Avery-Digital/Assem-Stn-2-Rev1/BOM/ASSEM_STN_Rev1_BOM_Populated.xlsx

DMF Assembly Station #2 PCB March 6th, 2026
Item | Designator | Description | Type | Temperature | Value | Mfr. | Mfr. P/N | Number Per Board | Number of Boards | Quantity Total | Distributor | Dist. P/N | Price Ea | Price Total Per Board | Available | QTY TO BUY | Total Buy | Date Updated | Foot Print | Notes
1 | U44 | IC DAC 16BIT V-OUT 16WQFN |  | -40°C ~ 125°C |  | Texas Instruments | DAC80508ZRTER | 1 | 4 | 4 | DigiKey | 296-51047-2-ND (https://www.digikey.com/en/products/detail/texas-instruments/DAC80508ZRTER/9659605) | $19.82 | $79.28 | 4837 | 6 | $118.92 | 03/06/2026
2 | U23 | IC EEPROM 2MBIT I2C 8SO |  | -40°C ~ 85°C (TA) |  | STMicroelectronics | M24M02E-FMN6TP | 1 | 4 | 4 | DigiKey | 497-M24M02E-FMN6TPTR-ND (https://www.digikey.com/en/products/detail/stmicroelectronics/M24M02E-FMN6TP/21700599) | $1.53 | $6.12 | 3684 | 10 | $15.30 | 03/06/2026
3 | U22 | IC OSC SILICON 33MHZ SOT-23-5 |  | -40°C ~ 125°C |  | Analog Devices Inc. | LTC1799HS5#TRPBF | 1 | 4 | 4 | DigiKey | 505-LTC1799HS5#TRPBFTR-ND (https://www.digikey.com/en/products/detail/analog-devices-inc/LTC1799HS5-TRPBF/961179) | $6.71 | $26.84 | 2060 | 6 | $40.26 | 03/06/2026
4 | U21 | IC MCU 32BIT 1MB FLASH 176LQFP |  | -40°C ~ 85°C (TA) |  | STMicroelectronics | STM32H735IGT6 | 1 | 4 | 4 | DigiKey | 497-STM32H735IGT6-ND (https://www.digikey.com/en/products/detail/stmicroelectronics/STM32H735IGT6/18086047) | $13.27 | $53.08 | 32 | 6 | $79.62 | 03/06/2026
5 | U20 | SENSOR OPT SLOT PHOTOTRANS MODUL |  | -30°C ~ 85°C |  | Omron Electronics Inc-EMC Div | EE-SX1320 | 1 | 4 | 4 | DigiKey | 39-EE-SX1320TR-ND (https://www.digikey.com/en/products/detail/omron-electronics-inc-emc-div/EE-SX1320/6600982) | $0.74 | $2.96 | 59692 | 10 | $7.40 | 03/06/2026
6 | U19 | IC USB SERIAL FULL UART 20QFN |  | -40°C ~ 85°C |  | FTDI, Future Technology Devices International Ltd | FT231XQ-T | 1 | 4 | 4 | DigiKey | 768-1155-ND (https://www.digikey.com/en/products/detail/ftdi-future-technology-devices-international-ltd/FT231XQ-T/3749470) | $2.34 | $9.36 | 0 | 10 | $23.40 | 03/06/2026 | Backordered, but shipdate is 3/9/2026
7 | U16 | IC REG BUCK ADJ 3A 8SOPWR |  | -40°C ~ 125°C (TJ) |  | Texas Instruments | LMR33630ADDAR | 1 | 4 | 4 | DigiKey | 296-49763-2-ND (https://www.digikey.com/en/products/detail/texas-instruments/LMR33630ADDAR/8554847) | $2.55 | $10.20 | 4851 | 10 | $25.50 | 03/06/2026
8 | U13, U15, U17, U18 | IC CURR SENSE 1 CIRCUIT SOT23-6 |  | -40°C ~ 125°C |  | Texas Instruments | INA181A3IDBVT | 4 | 4 | 16 | DigiKey | 296-46636-2-ND (https://www.digikey.com/en/products/detail/texas-instruments/INA181A3IDBVT/7219036) | $0.99 | $15.84 | 5188 | 25 | $24.75 | 03/06/2026
9 | U12, U14 | IC CURR SENSE 1 CIRCUIT SOT23-6 |  | -40°C ~ 125°C |  | Texas Instruments | INA181A1IDBVR | 2 | 4 | 8 | DigiKey | 296-47656-2-ND (https://www.digikey.com/en/products/detail/texas-instruments/INA181A1IDBVR/8132990) | $0.43 | $3.44 | 20081 | 25 | $10.75 | 03/06/2026
10 | U11, U45 | EIGHT-CHANNEL, 250-KSPS, 16-BIT |  | -40°C ~ 125°C |  | Texas Instruments | ADS7066IRTER | 2 | 4 | 8 | Mouser | 595-ADS7066IRTER (https://www.mouser.com/ProductDetail/Texas-Instruments/ADS7066IRTER?qs=ST9lo4GX8V1NXvZuWWBhPA%3D%3D) | $13.23 | $105.84 | 0 | 12 | $158.76 | 03/06/2026
11 | U10, U46 | 0.2% ACCURACY 15PPM 4V REF |  | -40°C ~ 145°C (TA) |  | NOVOSENSE | NSREF3140-DSTR | 2 | 4 | 8 | DigiKey | 5380-NSREF3140-DSTR-ND (https://www.digikey.com/en/products/detail/novosense/NSREF3140-DSTR/22188769) | $2.02 | $16.16 | 2667 | 12 | $24.24 | 03/06/2026
12 | U8, U9 | IC HALF BRIDG DRV 600MA 32VFQFPN |  | -20°C ~ 125°C (TJ) |  | STMicroelectronics | L2293Q | 2 | 4 | 8 | DigiKey | 497-L2293Q-ND (https://www.digikey.com/en/products/detail/stmicroelectronics/L2293Q/5051121) | $7.49 | $59.92 | 2991 | 12 | $89.88 | 03/06/2026
13 | U7 | IC MOTOR DRIVER 5.5V-45V 32VQFN |  | -40°C ~ 150°C (TJ) |  | Texas Instruments | DRV8702DQRHBRQ1 | 1 | 4 | 4 | DigiKey | 296-DRV8702DQRHBRQ1TR-ND (https://www.digikey.com/en/products/detail/texas-instruments/DRV8702DQRHBRQ1/7056223) | $2.75 | $11.00 | 3848 | 10 | $27.50 | 03/06/2026
14 | U5, U6, U33 | IC PWR DRIVER N-CHANNEL 1:1 HPAK |  | -40°C ~ 150°C (TJ) |  | STMicroelectronics | VN5T016AHTR-E | 3 | 4 | 12 | DigiKey | 497-14315-2-ND (https://www.digikey.com/en/products/detail/stmicroelectronics/VN5T016AHTR-E/4357474) | $3.84 | $46.08 | 260 | 25 | $96.00 | 03/06/2026
15 | U4 | IC REG LINEAR 3.3V 1A SOT-223-3 |  | -40°C ~ 125°C |  | Microchip Technology | MCP1826S-3302E/DB | 1 | 4 | 4 | DigiKey | MCP1826S-3302E/DB-ND (https://www.digikey.com/en/products/detail/microchip-technology/MCP1826S-3302E-DB/1635997) | $0.91 | $3.64 | 6517 | 12 | $10.92 | 03/06/2026
16 | U3 | IC XLTR VL BIDIR 14-TSSOP |  | -40°C ~ 125°C (TA) |  | Texas Instruments | TXB0104QPWRQ1 | 1 | 4 | 4 | DigiKey | 296-27760-2-ND (https://www.digikey.com/en/products/detail/texas-instruments/TXB0104QPWRQ1/2232941) | $1.42 | $5.68 | 10963 | 10 | $14.20 | 03/06/2026
17 | U2 | IC TRANSCEIVER 0/4 16TSSOP |  | -40°C ~ 85°C |  | Texas Instruments | AM26C32IPWR | 1 | 4 | 4 | DigiKey | 296-30088-2-ND (https://www.digikey.com/en/products/detail/texas-instruments/AM26C32IPWR/1689930) | $1.06 | $4.24 | 3091 | 25 | $26.50 | 03/06/2026
18 | U1 | IC MTR DRVR BIPLR 8.2-45V 28SSOP |  | -40°C ~ 150°C (TJ) |  | Texas Instruments | DRV8825PWP | 1 | 4 | 4 | DigiKey | 296-28915-5-ND (https://www.digikey.com/en/products/detail/texas-instruments/DRV8825PWP/2676775) | $5.95 | $23.80 | 10534 | 10 | $59.50 | 03/06/2026
19 | TP10, TP11 | PC TEST POINT MULTIPURPOSE BLACK |  |  |  | Keystone Electronics | 5011 | 2 | 4 | 8 | DigiKey | 36-5011-ND (https://www.digikey.com/en/products/detail/keystone-electronics/5011/255333) | $0.32 | $2.56 | 146584 | 100 | $32.00 | 03/06/2026 | DNI
20 | TP8, TP9, TP12 | PC TEST POINT MULTIPURPOSE WHITE |  |  |  | Keystone Electronics | 5012 | 3 | 4 | 12 | DigiKey | 36-5012-ND (https://www.digikey.com/en/products/detail/keystone-electronics/5012/255334) | $0.32 | $3.84 | 152177 | 100 | $32.00 | 03/06/2026 | DNI
21 | TP1, TP2, TP3, TP4, TP5, TP6, TP7 | PC TEST POINT MULTIPURPOSE RED |  |  |  | Keystone Electronics | 5010 | 7 | 4 | 28 | DigiKey | 36-5010-ND (https://www.digikey.com/en/products/detail/keystone-electronics/5010/255332) | $0.34 | $9.52 | 169024 | 100 | $34.00 | 03/06/2026 | DNI
22 | R196 | RES SMD 8.25K OHM 0.1% 1/8W 0805 |  | -55°C ~ 155°C |  | Panasonic Electronic Components | ERA-6AEB8251V | 1 | 4 | 4 | DigiKey | 10-ERA-6AEB8251VTR-ND (https://www.digikey.com/en/products/detail/panasonic-electronic-components/ERA-6AEB8251V/2025746) | $0.10 | $0.40 | 16222 | 50 | $5.00 | 03/06/2026
23 | R171 | RES 470 OHM 1% 1/8W 0805 |  | -55°C ~ 155°C |  | YAGEO | RC0805FR-07470RL | 1 | 4 | 4 | DigiKey | 311-470CRTR-ND (https://www.digikey.com/en/products/detail/yageo/RC0805FR-07470RL/727976) | $0.10 | $0.40 | 179968 | 250 | $25.00 | 03/06/2026
24 | R154, R156 | RES 27 OHM 1% 1/8W 0805 |  | -55°C ~ 155°C |  | Stackpole Electronics Inc | RMCF0805FT27R0 | 2 | 4 | 8 | DigiKey | 738-RMCF0805FT27R0TR-ND (https://www.digikey.com/en/products/detail/stackpole-electronics-inc/RMCF0805FT27R0/1712920) | $0.10 | $0.80 | 96405 | 250 | $25.00 | 03/06/2026
25 | R112, R118 | RES SMD 100K OHM 0.1% 1/8W 0805 |  | -55°C ~ 155°C |  | Susumu | RG2012P-104-B-T5 | 2 | 4 | 8 | DigiKey | RG20P100KBTR-ND (https://www.digikey.com/en/products/detail/susumu/RG2012P-104-B-T5/1240656) | $0.10 | $0.80 | 312029 | 250 | $25.00 | 03/06/2026
26 | R84 | RES 0.015 OHM 1% 3W 2512 |  | -55°C ~ 170°C |  | Bourns Inc. | CRA2512-FZ-R015ELF | 1 | 4 | 4 | DigiKey | CRA2512-FZ-R015ELFTR-ND (https://www.digikey.com/en/products/detail/bourns-inc/CRA2512-FZ-R015ELF/2563864) | $0.55 | $2.20 | 95500 | 100 | $55.00 | 03/06/2026
27 | R55, R63, R67, R169 | RES 22K OHM 1% 1/8W 0805 |  | -55°C ~ 155°C |  | YAGEO | RC0805FR-1322KL | 4 | 4 | 16 | DigiKey | 13-RC0805FR-1322KLTR-ND (https://www.digikey.com/en/products/detail/yageo/RC0805FR-1322KL/14008208) | $0.10 | $1.60 | 278907 | 250 | $25.00 | 03/06/2026
28 | R54, R62, R66 | RES SMD 1K OHM 1% 1/4W 0805 |  | -55°C ~ 155°C |  | Vishay Dale | CRCW08051K00FKEA | 3 | 4 | 12 | DigiKey | 541-1.00KCTR-ND (https://www.digikey.com/en/products/detail/vishay-dale/CRCW08051K00FKEA/1175637) | $0.10 | $1.20 | 651385 | 250 | $25.00 | 03/06/2026
29 | R47 | RES 24.9K OHM 1% 1/8W 0805 |  | -55°C ~ 155°C |  | Stackpole Electronics Inc | RMCF0805FT24K9 | 1 | 4 | 4 | DigiKey | RMCF0805FT24K9TR-ND (https://www.digikey.com/en/products/detail/stackpole-electronics-inc/RMCF0805FT24K9/1760179) | $0.10 | $0.40 | 57139 | 250 | $25.00 | 03/06/2026
30 | R46 | RES 330 OHM 1% 1/8W 0805 |  | -55°C ~ 155°C |  | Stackpole Electronics Inc | RMCF0805FT330R | 1 | 4 | 4 | DigiKey | RMCF0805FT330RTR-ND (https://www.digikey.com/en/products/detail/stackpole-electronics-inc/RMCF0805FT330R/1760484) | $0.10 | $0.40 | 131778 | 250 | $25.00 | 03/06/2026
31 | R44, R48, R56, R58 | RES 0.04 OHM 0.5% 1/2W 0805 |  | -65°C ~ 170°C |  | Vishay Dale | WSLP0805R0400DEA | 4 | 4 | 16 | DigiKey | 541-WSLP0805R0400DEATR-ND (https://www.digikey.com/en/products/detail/vishay-dale/WSLP0805R0400DEA/9755281) | $2.50 | $40.00 | 3056 | 25 | $62.50 | 03/06/2026
32 | R43, R45 | RES 100K OHM 1% 1/8W 0805 |  | -55°C ~ 155°C |  | YAGEO | RC0805FR-07100KL | 2 | 4 | 8 | DigiKey | 311-100KCRTR-ND (https://www.digikey.com/en/products/detail/yageo/RC0805FR-07100KL/727544) | $0.10 | $0.80 | 1049600 | 1000 | $100.00 | 03/06/2026
33 | R23, R35, R49, R151, R152 | RES SMD 100 OHM 1% 1/4W 0805 |  | -55°C ~ 155°C |  | Vishay Dale | CRCW0805100RFKEA | 5 | 4 | 20 | DigiKey | 541-100CTR-ND (https://www.digikey.com/en/products/detail/vishay-dale/CRCW0805100RFKEA/1175523) | $0.10 | $2.00 | 148684 | 250 | $25.00 | 03/06/2026
34 | R19, R193, R194 | RES 4.99K OHM 1% 1/8W 0805 |  | -55°C ~ 155°C |  | Stackpole Electronics Inc | RMCF0805FT4K99 | 3 | 4 | 12 | DigiKey | RMCF0805FT4K99TR-ND (https://www.digikey.com/en/products/detail/stackpole-electronics-inc/RMCF0805FT4K99/1760698) | $0.10 | $1.20 | 174416 | 250 | $25.00 | 03/06/2026
35 | R15 | RES 49.9K OHM 1% 1/8W 0805 |  | -55°C ~ 155°C |  | Stackpole Electronics Inc | RMCF0805FT49K9 | 1 | 4 | 4 | DigiKey | RMCF0805FT49K9TR-ND (https://www.digikey.com/en/products/detail/stackpole-electronics-inc/RMCF0805FT49K9/1760272) | $0.10 | $0.40 | 175340 | 250 | $25.00 | 03/06/2026
36 | R13, R14 | RES 0.2 OHM 1% 1/2W 0805 |  | -55°C ~ 155°C |  | Panasonic Electronic Components | ERJ-6DSFR20V | 2 | 4 | 8 | DigiKey | P19315TR-ND (https://www.digikey.com/en/products/detail/panasonic-electronic-components/ERJ-6DSFR20V/6004398) | $0.27 | $2.16 | 67367 | 250 | $67.50 | 03/06/2026
37 | R12 | RES SMD 1M OHM 1% 1/4W 0805 |  | -55°C ~ 155°C |  | Vishay Dale | CRCW08051M00FKEA | 1 | 4 | 4 | DigiKey | 541-1.00MCTR-ND (https://www.digikey.com/en/products/detail/vishay-dale/CRCW08051M00FKEA/1176016) | $0.10 | $0.40 | 136752 | 250 | $25.00 | 03/06/2026
38 | R8, R9, R10, R16, R177 | RES 0 OHM JUMPER 1/8W 0805 |  | -55°C ~ 155°C |  | YAGEO | RC0805JR-070RL | 5 | 4 | 20 | DigiKey | 311-0.0ARTR-ND (https://www.digikey.com/en/products/detail/yageo/RC0805JR-070RL/728216) | $0.10 | $2.00 | 1087280 | 0 | $0.00 | 03/06/2026 | DNI
39 | R7, R11, R52, R53, R60, R61, R64, R65, R75, R83, R88, R89, R90, R91, R92, R93, R94, R95, R96, R97, R168, R178, R184, R205 | RES SMD 10K OHM 1% 1/4W 0805 |  | -55°C ~ 155°C |  | Vishay Dale | CRCW080510K0FKEA | 24 | 4 | 96 | DigiKey | 541-10.0KCTR-ND (https://www.digikey.com/en/products/detail/vishay-dale/CRCW080510K0FKEA/1175751) | $0.10 | $9.60 | 1218191 | 500 | $50.00 | 03/06/2026
40 | R6, R50 | RES 0.02 OHM 0.5% 1/2W 0805 |  | -55°C ~ 125°C |  | Panasonic Electronic Components | ERJ-6CWDR020V | 2 | 4 | 8 | DigiKey | P124408TR-ND (https://www.digikey.com/en/products/detail/panasonic-electronic-components/ERJ-6CWDR020V/10261701) | $0.61 | $4.88 | 4174 | 25 | $15.25 | 03/06/2026
41 | R1, R2, R3, R4, R5, R17, R18, R20, R21, R22, R24, R25, R26, R27, R28, R29, R30, R31, R32, R33, R34, R36, R37, R38, R39, R40, R41, R42, R51, R57, R59, R68, R69, R70, R71, R72, R73, R74, R76, R77, R78, R79, R80, R81, R82, R85, R86, R87, R98, R99, R100, R101, R102, R103, R104, R105, R106, R107, R108, R109, R110, R111, R113, R114, R115, R116, R117, R119, R120, R121, R122, R123, R124, R125, R126, R127, R128, R129, R130, R131, R132, R133, R134, R135, R136, R137, R138, R139, R140, R141, R142, R143, R144, R145, R146, R147, R148, R149, R150, R153, R155, R157, R158, R159, R160, R161, R162, R163, R164, R165, R166, R167, R170, R172, R173, R174, R175, R176, R179, R180, R181, R182, R183, R185, R186, R187, R188, R189, R190, R191, R192, R195, R197, R198, R199, R200, R201, R202, R203, R204, R206, R207, R208, R209, R210, R211, R212, R213, R214, R215, R216, R217, R218, R219, R220, R221, R222, R223, R224, R225, R226 | RES 0 OHM JUMPER 1/8W 0805 |  | -55°C ~ 155°C |  | YAGEO | RC0805JR-070RL | 161 | 4 | 644 | DigiKey | 311-0.0ARTR-ND (https://www.digikey.com/en/products/detail/yageo/RC0805JR-070RL/728216) | $0.10 | $64.40 | 1087280 | 1000 | $100.00 | 03/06/2026
42 | Q1, Q2, Q3, Q4 | BUK7S2R0-40H/SOT1235/LFPAK88 |  | -55°C ~ 175°C (TJ) |  | Nexperia USA Inc. | BUK7S2R0-40HJ | 4 | 4 | 16 | DigiKey | 1727-BUK7S2R0-40HJTR-ND (https://www.digikey.com/en/products/detail/nexperia-usa-inc/BUK7S2R0-40HJ/15777942) | $3.14 | $50.24 | 1411 | 25 | $78.50 | 03/06/2026
43 | L4 | FIXED IND 2.2UH 1.2A 138 MOHM |  | -55°C ~ 125°C |  | Murata Electronics | LQM2MPN2R2MG0L | 1 | 4 | 4 | DigiKey | 490-12072-2-ND (https://www.digikey.com/en/products/detail/murata-electronics/LQM2MPN2R2MG0L/4359179) | $0.18 | $0.72 | 41770 | 50 | $9.00 | 03/06/2026
44 | L2, L3 | FIXED IND 15UH 12.5A 20.5 MOHM |  | -40°C ~ 150°C |  | Bourns Inc. | SRP1770TA-150M | 2 | 4 | 8 | DigiKey | SRP1770TA-150MTR-ND (https://www.digikey.com/en/products/detail/bourns-inc/SRP1770TA-150M/5429636) | $3.52 | $28.16 | 1663 | 15 | $52.80 | 03/06/2026
45 | L1 | FIXED IND 8.2UH 6.25A 20 MOHM |  | -40°C ~ 125°C |  | Würth Elektronik | 744771008 | 1 | 4 | 4 | DigiKey | 732-1207-2-ND (https://www.digikey.com/en/products/detail/würth-elektronik/744771008/1638612) | $2.26 | $9.04 | 85 | 10 | $22.60 | 03/06/2026
46 | J16 | CONN HEADER VERT 10POS 1.27MM |  | -55°C ~ 125°C |  | Samtec Inc. | SHF-105-01-L-D-TH | 1 | 4 | 4 | DigiKey | SAM10711-ND (https://www.digikey.com/en/products/detail/samtec-inc/SHF-105-01-L-D-TH/6561671) | $2.32 | $9.28 | 10547 | 6 | $13.92 | 03/06/2026
47 | J15, J17 | CONN HEADER VERT 2POS 2.54MM |  | -40°C ~ 105°C |  | Harwin Inc. | M20-9730245 | 2 | 4 | 8 | DigiKey | 952-1912-ND (https://www.digikey.com/en/products/detail/harwin-inc/M20-9730245/3727879) | $0.14 | $1.12 | 5170 | 500 | $70.00 | 03/06/2026 | DNI
48 | J14 | CONN HEADER VERT 6POS 2.5MM |  | -40°C ~ 105°C |  | Molex | 1053091306 | 1 | 4 | 4 | DigiKey | WM15040-ND (https://www.digikey.com/en/products/detail/molex/1053091306/6164129) | $2.68 | $10.72 | 2329 | 6 | $16.08 | 03/06/2026
49 | J13 | CONN HEADER SMD 2POS 1.25MM |  | -35°C ~ 85°C |  | Hirose Electric Co Ltd | DF13-2P-1.25V(75) | 1 | 4 | 4 | DigiKey | H126391-ND (https://www.digikey.com/en/products/detail/hirose-electric-co-ltd/DF13-2P-1-25V-75/9170623) | $0.35 | $1.40 | 101 | 6 | $2.10 | 03/06/2026
50 | J6 | CONN HEADER VERT 3POS 3.5MM |  | -40°C ~ 105°C |  | Molex | 1722861103 | 1 | 4 | 4 | Mouser | 538-172286-1103 (https://www.mouser.com/ProductDetail/Molex/172286-1103?qs=M4iqfhoVaNopV1IS%252Blu7xQ%3D%3D) | $0.78 | $3.12 | 741 | 6 | $4.68 | 03/06/2026
51 | J5 | CONN HEADER VERT 3POS 2.5MM |  | -40°C ~ 105°C |  | Molex | 1053091103 | 1 | 4 | 4 | DigiKey | WM16866-ND (https://www.digikey.com/en/products/detail/molex/1053091103/7693147) | $1.01 | $4.04 | 20913 | 6 | $6.06 | 03/06/2026
52 | J4 | CONN HEADER VERT 2POS 2.5MM |  | -40°C ~ 105°C |  | Molex | 1053091102 | 1 | 4 | 4 | DigiKey | WM16865-ND (https://www.digikey.com/en/products/detail/molex/1053091102/7693146) | $0.71 | $2.84 | 10314 | 6 | $4.26 | 03/06/2026
53 | J3 | CONN HEADER VERT 4POS 2.5MM |  | -40°C ~ 105°C |  | Molex | 1053091104 | 1 | 4 | 4 | DigiKey | WM16867-ND (https://www.digikey.com/en/products/detail/molex/1053091104/7693148) | $1.15 | $4.60 | 12586 | 6 | $6.90 | 03/06/2026
54 | J2, J7, J8, J9, J10, J11, J12 | CONN HEADER VERT 2POS 3.5MM |  | -40°C ~ 105°C |  | Molex | 1722861102 | 7 | 4 | 28 | DigiKey | WM11570-ND (https://www.digikey.com/en/products/detail/molex/1722861102/5344267) | $0.77 | $21.56 | 8471 | 50 | $38.50 | 03/06/2026
55 | J1 | CONN HEADER VERT 5POS 2.5MM |  | -40°C ~ 105°C |  | Molex | 1053091105 | 1 | 4 | 4 | DigiKey | WM16868-ND (https://www.digikey.com/en/products/detail/molex/1053091105/7693149) | $1.40 | $5.60 | 778 | 6 | $8.40 | 03/06/2026
56 | FID1, FID2, FID3, FID4, FID5, FID6 |  |  |  |  |  |  | 6 | 4 | 24 |  |  |  | $0.00 |  |  | $0.00 |  | DNI
57 | D10, D11 | LED GREEN CLEAR 0805 SMD |  |  |  | Visual Communications Company - VCC | LSM0805452V | 2 | 4 | 8 | DigiKey | 28-LSM0805463VTR-ND (https://www.digikey.com/en/products/detail/visual-communications-company-vcc/LSM0805463V/10229614) | $0.43 | $3.44 | 3639 | 25 | $10.75 | 03/06/2026
58 | D6, D7, D8, D9 | DIODE SCHOTTKY 100V 2A SMB |  | -65°C ~ 150°C |  | Diodes Incorporated | B2100Q-13-F | 4 | 4 | 16 | DigiKey | 31-B2100Q-13-FTR-ND (https://www.digikey.com/en/products/detail/diodes-incorporated/B2100Q-13-F/6187178) | $0.57 | $9.12 | 66 | 25 | $14.25 | 03/06/2026
59 | D1, D2, D3, D4, D5 | LED BLUE CLEAR 0805 SMD |  |  |  | Visual Communications Company - VCC | LSM0805463V | 5 | 4 | 20 | DigiKey | 28-LSM0805463VTR-ND (https://www.digikey.com/en/products/detail/visual-communications-company-vcc/LSM0805463V/10229614) | $0.43 | $8.60 | 3639 | 50 | $21.50 | 03/06/2026
60 | C98, C99 | CAP CER 47PF 50V C0G/NP0 0805 |  | -55°C ~ 125°C |  | KEMET | C0805X470J5GACTU | 2 | 4 | 8 | DigiKey | 399-C0805X470J5GACTUTR-ND (https://www.digikey.com/en/products/detail/kemet/C0805X470J5GACTU/3317646) | $0.32 | $2.56 | 52749 | 250 | $80.00 | 03/06/2026
61 | C68, C69, C70, C71, C72, C73, C74, C75, C78, C79, C80, C81, C82, C83, C84, C85 | CAP CER 0.1UF 50V X7R 0805 |  | -55°C ~ 125°C |  | KYOCERA AVX | KGM21NR71H104KT | 16 | 4 | 64 | DigiKey | 478-KGM21NR71H104KTTR-ND (https://www.digikey.com/en/products/detail/kyocera-avx/KGM21NR71H104KT/563505) | $0.08 | $5.12 | 1967436 |  | $0.00 | 03/06/2026 | DNI
62 | C44, C45, C46, C47, C48, C49, C50, C51 | CAP CER 22UF 50V X7R 2220 |  | -55°C ~ 125°C |  | TDK Corporation | C5750X7R1H226M250KB | 8 | 4 | 32 | DigiKey | 445-C5750X7R1H226M250KBTR-ND (https://www.digikey.com/en/products/detail/tdk-corporation/C5750X7R1H226M250KB/13672015) | $4.39 | $140.48 | 8211 | 50 | $219.50 | 03/06/2026
63 | C17, C21, C24, C36 | CAP CER 1UF 50V X7R 0805 |  | -55°C ~ 125°C |  | Samsung Electro-Mechanics | CL21B105KBFNNNE | 4 | 4 | 16 | DigiKey | 1276-1029-2-ND (https://www.digikey.com/en/products/detail/samsung-electro-mechanics/CL21B105KBFNNNE/3886687) | $0.12 | $1.92 | 1573586 | 250 | $30.00 | 03/06/2026
64 | C14, C15, C16 | CAP CER 47UF 10V X5R 0805 |  | -55°C ~ 85°C |  | Murata Electronics | GRM21BR61A476ME15L | 3 | 4 | 12 | DigiKey | 490-9961-2-ND (https://www.digikey.com/en/products/detail/murata-electronics/GRM21BR61A476ME15L/4905529) | $0.53 | $6.36 | 1371228 | 100 | $53.00 | 03/06/2026
65 | C12 | CAP CER 0.22UF 50V X7R 0805 |  | -55°C ~ 125°C |  | KEMET | C0805C224K5RACTU | 1 | 4 | 4 | DigiKey | 399-C0805C224K5RACTUTR-ND (https://www.digikey.com/en/products/detail/kemet/C0805C224K5RACTU/754753) | $0.08 | $0.32 | 454948 | 250 | $20.00 | 03/06/2026
66 | C11, C18, C19, C20, C25, C26, C27, C28, C29, C30, C31, C32, C33, C34, C35, C39, C41, C43, C52, C53, C54, C55, C56, C57, C58, C59, C60, C62, C64, C65, C67, C76, C77, C87, C88, C89, C96, C103, C104, C107, C108, C109, C110, C111 | CAP CER 10UF 50V X5R 0805 |  | -55°C ~ 85°C |  | Murata Electronics | GRM21BR61H106KE43L | 44 | 4 | 176 | DigiKey | 490-18663-2-ND (https://www.digikey.com/en/products/detail/murata-electronics/GRM21BR61H106KE43L/10326316) | $0.30 | $52.80 | 1051449 | 500 | $150.00 | 03/06/2026
67 | C6 | CAP ALUM 100UF 20% 50V SMD |  | -55°C ~ 105°C |  | Nichicon | UWT1H101MNL1GS | 1 | 4 | 4 | DigiKey | 493-2226-2-ND (https://www.digikey.com/en/products/detail/nichicon/UWT1H101MNL1GS/589967) | $0.55 | $2.20 | 92915 | 6 | $3.30 | 03/06/2026
68 | C3 | CAP CER 0.47UF 50V X7R 0805 |  | -55°C ~ 125°C |  | Murata Electronics | GRM21BR71H474KA88L | 1 | 4 | 4 | DigiKey | 490-3328-2-ND (https://www.digikey.com/en/products/detail/murata-electronics/GRM21BR71H474KA88L/702592) | $0.21 | $0.84 | 235830 | 100 | $21.00 | 03/06/2026
69 | C2, C4, C5, C7, C8, C9, C10, C13, C37, C38, C40, C42, C61, C63, C66, C86, C90, C91, C92, C93, C94, C95, C97, C100, C101, C102, C105, C106, C112, C113, C114, C115, C116, C117, C118, C119, C120, C121, C122, C123, C124, C125, C126, C127, C128, C129, C130, C131 | CAP CER 0.1UF 50V X7R 0805 |  | -55°C ~ 125°C |  | KYOCERA AVX | KGM21NR71H104KT | 48 | 4 | 192 | DigiKey | 478-KGM21NR71H104KTTR-ND (https://www.digikey.com/en/products/detail/kyocera-avx/KGM21NR71H104KT/563505) | $0.08 | $15.36 | 1967436 | 1000 | $80.00 | 03/06/2026
70 | C1, C22, C23 | CAP CER 10000PF 50V X7R 0805 |  | -55°C ~ 125°C |  | KYOCERA AVX | KGM21NR71H103KT | 3 | 4 | 12 | DigiKey | 478-KGM21NR71H103KTTR-ND (https://www.digikey.com/en/products/detail/kyocera-avx/KGM21NR71H103KT/563493) | $0.10 | $1.20 | 656657 | 100 | $10.00 | 03/06/2026
71
72
73
74
75
76
77
78
79
80
81
82
83
84
85
86
87
88
89
90
91
92
93
94
95
96
97
98
99
100
101
102
103
104
105
106
107
108
109
110
111
112
113
114
115
116
117
118
119
120
121
