Avery-Digital/Assem-Stn-2-Rev1/Quotes/PO - Assembly Station #2 - Assembly.xlsx

 | Avery Bio Corporation |  |  |  | Purchase Order
 | www.averybio.com |  |  | Date | 2026-03-24
 | ap@avery.tech |  |  | PO # | 20260324CCQ(SIC
 | (703) 869-9382 |  |  | Requester: | Cam Carrillo
 | 11025 N Torrey Pines Rd., STE 100 |  |  | Requester Email: | Cam.carrillo@avery.tech
 | La Jolla, CA 92037
 | Vendor: | QSIC (Quality Systems Integrated Corporation)
 | Address:
 | Website:
 | Phone:
 | Contact Name: | Liz Yeung
 | Contact Email: | liz.yeung@qsic.com
 | Quote #: | AVERYTECH26-02(CG)
 | Ship To Address: | Avery Bio Corporation, 11025 N Torrey Pines Rd., STE 100, La Jolla, CA 92037, USA
 | Attention: | Cam Carrillo
Line | Part# | Description | Date Required | Qty | Unit Price | Subtotal
1 | ASSEM_STN_Rev1 | Assembly Station #2 -Component Assembly | 2026-04-08 | 4 | $295.00 | $1180.00
2 | ASSEM_STN_Rev1 | NRE - Stencils | 2026-04-08 | 2 | $400.00 | $800.00
 |  |  |  |  |  | $0.00
 |  |  |  |  |  | $0.00
 |  |  |  |  |  | $0.00
Notes: |  |  |  |  | Sub Total | $1180.00
 |  |  |  |  | Sales tax | -
 |  |  |  |  | Shipping | -
 |  |  |  |  | Total | $1180.00
 |  |  |  | Authorized Signature:
 |  |  | Name: | Ryan de Ridder
 |  |  | Date: | 2026-03-24
