Avery-Digital/Assem-Stn-2-Rev1/PCB1.step

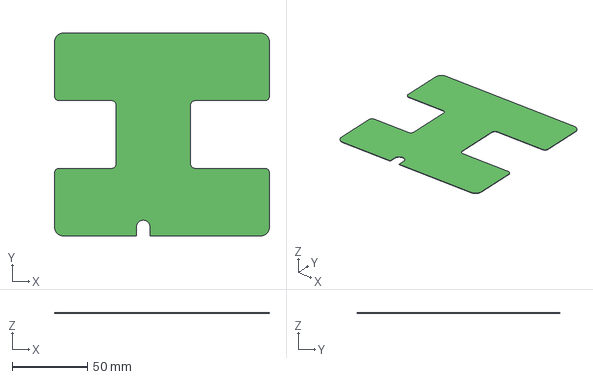
[picture p1: CAD file, 2026-04-16]
PCB1.step
143.0 x 135.0 x 0.411 mm
