Avery-Digital/Assem-Stn-2-Rev1/ASSEM_STN_2_Rev1 - Fabrication Drawing.pdf

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
1 | 1
2 | 2
3 | 3
4 | 4

Fabricate per IPC-6012 (latest revision) Class 2, with exceptions:
- Minimum annular rings - tangency requirement, no break-outs.

1.

2. Inspect per IPC-A-600 (latest revision) Class 2
3. Dimensional and locational tolerances are ±0.005in from Gerber data supplied.
4. Overall finished board thickness: =Total thickness in ±10%
5. Avery Bio Corp. must approve proposed material and stackup prior to fabrication.
6. All via/hole dimensions are finished (after plating) and tolerances are ±0.002in unless otherwise specified.

Controlled Impedence Requirements: None or See table, impedence (TDR) coupon testing is required, per IPC-TM-650 (latest revision).
- Line width or stackup changes to meet controlled impedence require Avery Bio Corp. approval before fabrication.

7.

Soldermask, per IPC-SM-840 (latest revision): LPIOBC both sides, GREEN.
- Soldermask webs of 0.0035 or greater must be maintained.
- Soldermask registration shall be <0.002 from supplied gerber data.

8.

9. SilkScreen: none or both sides, white. No silkscreen to be present on any solderable component pad.
10. Electrical testing is required per IPC-ET-652 (latest revision).
11. Removal of non-functional pads on inner layers is not allowed.
12. Internal thieving is not permitted except in perimeter rail area outside subpanel outlines (0.075in min).
13. Markings on individual boards/subpanels (including test stamp) is not allowed.
14. Serialization is required: In array area or bag and tag when shipped individually.

Via cross section samples, per TPC-TM-650 (latest revision), are required for each type of via in the drill table, including analysis report per IPC-6012 (latest revision).

15.

16. Certificate of Compliance is required with lot delivery.

Any deviation from supplied generated Gerbers other than stated must be approved by Avery Bio Corp. prior to fabrication.

17.

Packaging: All PCBs shall be delivered in Moisture Barrier Bags and include appropiate desiccant material and a Humidity Indicator Card per IPC-1601 (latest revision).

18.

Solder sample array is required, may be non-functional, and shall be marked and packaged seperately from the other boards.

19.

Note:

TITLE

1

SHEET:
2

OF

PCB PART NUMBER
ASSEM_STN_REV1

FILENAME
ASSEM_STN_2_Rev1 - Fabrication
Material | Layer | Thickness Dielectric Material Type | Gerber
| Top Overlay | | Legend | GTO
Surface Material Top Solder | 0.010mm Solder Resist | Solder Mask GTS
Copper | Top Layer | 0.036mm | Signal | GTL
Prepreg | | 0.100mm PP-006 | Dielectric
CF-004 | GND 2 | 0.035mm | Signal | G1
Core | | 0.200mm PP-006 | Dielectric
CF-004 | SIG 3 | 0.035mm | Signal | G2
Prepreg | | 0.100mm PP-006 | Dielectric
CF-004 | PWR 5V | 0.035mm | Signal | G3
Core | 0.400mm FR-4 | Dielectric
CF-004 | PWR 3V3 | 0.035mm | Signal | G4
Prepreg | | 0.100mm PP-006 | Dielectric
CF-004 | SIG 6 | 0.035mm | Signal | G5
Core | | 0.200mm PP-006 | Dielectric
CF-004 | GND 7 | 0.035mm | Signal | G6
Prepreg | | 0.100mm PP-006 | Dielectric
Copper | Bottom Layer 0.036mm | Signal | GBL
Surface Material Bottom Solder 0.010mm Solder Resist | Solder Mask GBS
| Bottom Overlay | | Legend | GBO
Total thickness: 1.501mm

Layer Stack Legend

ASSEM_STN_REV1 - Fabrication Drawing

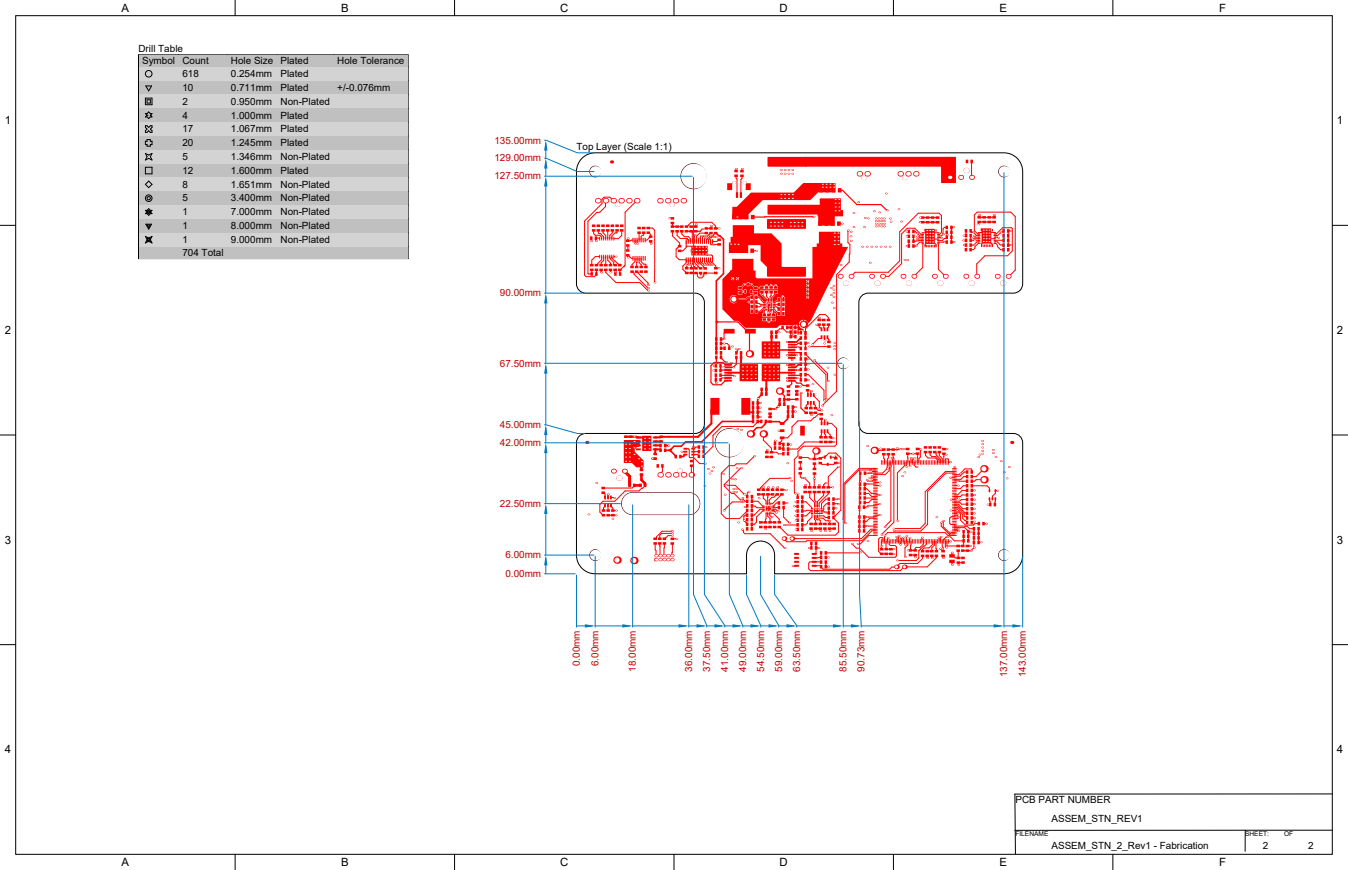
[picture p2: page 2]
ASSEM_STN_2_Rev1 - Fabrication; FILENAME; ASSEM_STN_REV1; SHEET: 2; Drill Table

Symbol | Count | Hole Size | Plated | Hole Tolerance

618 | 0.254mm | Plated
10 | 0.711mm | Plated | +/-0.076mm
2 | 0.950mm | Non-Plated
4 | 1.000mm | Plated
17 | 1.067mm | Plated
20 | 1.245mm | Plated
5 | 1.346mm | Non-Plated
12 | 1.600mm | Plated
8 | 1.651mm | Non-Plated
5 | 3.400mm | Non-Plated
1 | 7.000mm | Non-Plated
1 | 8.000mm | Non-Plated
1 | 9.000mm | Non-Plated
704 Total

Top Layer (Scale 1:1)

PCB PART NUMBER
