Avery-Digital/Assem-Stn-2-Rev1/30017-02 CONTROL PCB ASSEMBLY, ASSY STATION #2.pdf

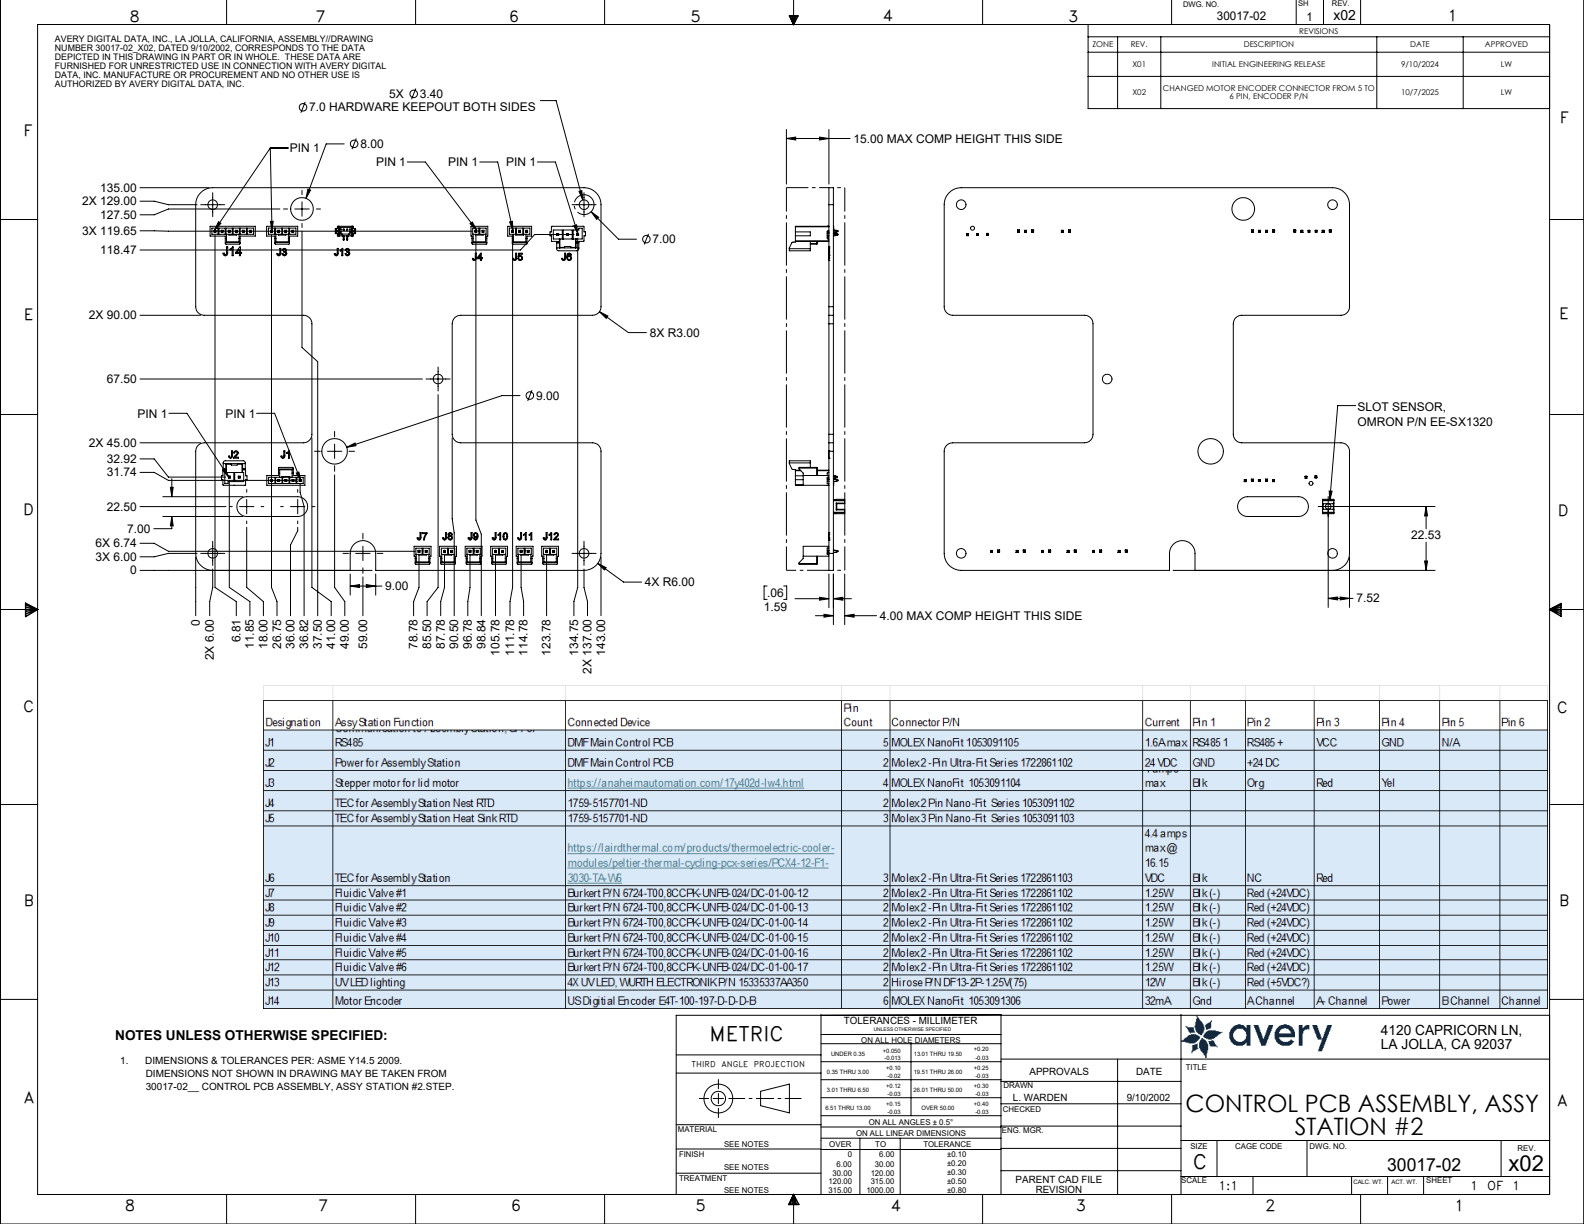
[picture p3: page 1]
PIN 1; SLOT SENSOR, OMRON P/N EE-SX1320; DWG. NO.; REV.; SEE NOTES; STATION #2; L. WARDEN; ON ALL LINEAR DIMENSIONS; ON ALL ANGLES ± 0.5°; 3.01 THRU 6.50; 6.51 THRU 13.00; 0.35 THRU 3.00; 26.01 THRU 50.00; OVER 50.00; 19.51 THRU 26.00; UNDER 0.35; 13.01 THRU 19.50 +0.050; SCALE; CALC. WT. ACT. WT. SHEET; SIZE; CAGE CODE; ENG. MGR.

REVISIONS

AVERY DIGITAL DATA, INC., LA JOLLA, CALIFORNIA, ASSEMBLY//DRAWING
NUMBER 30017-02_X02, DATED 9/10/2002, CORRESPONDS TO THE DATA
DEPICTED IN THIS DRAWING IN PART OR IN WHOLE. THESE DATA ARE
FURNISHED FOR UNRESTRICTED USE IN CONNECTION WITH AVERY DIGITAL
DATA, INC. MANUFACTURE OR PROCUREMENT AND NO OTHER USE IS
AUTHORIZED BY AVERY DIGITAL DATA, INC.

ZONE | REV. | DESCRIPTION | DATE | APPROVED

X01 | INITIAL ENGINEERING RELEASE | 9/10/2024 | LW

X02 | CHANGED MOTOR ENCODER CONNECTOR FROM 5 TO 6 PIN, ENCODER P/N | 10/7/2025 | LW

7.0 HARDWARE KEEPOUT BOTH SIDES

15.00 MAX COMP HEIGHT THIS SIDE

4.00 MAX COMP HEIGHT THIS SIDE

TOLERANCES - MILLIMETER
ON ALL HOLE DIAMETERS

NOTES UNLESS OTHERWISE SPECIFIED:

UNLESS OTHERWISE SPECIFIED

4120 CAPRICORN LN,
LA JOLLA, CA 92037

1. DIMENSIONS & TOLERANCES PER: ASME Y14.5 2009.
DIMENSIONS NOT SHOWN IN DRAWING MAY BE TAKEN FROM
30017-02__ CONTROL PCB ASSEMBLY, ASSY STATION #2.STEP.

THIRD ANGLE PROJECTION

TITLE
CONTROL PCB ASSEMBLY, ASSY

PARENT CAD FILE
REVISION
