Avery-Digital/Assem-Stn-2-Rev1/ASSEM_STN_2_Rev1 - Assembly Drawing.pdf

# U8 U9 U²² L4

J13 L1

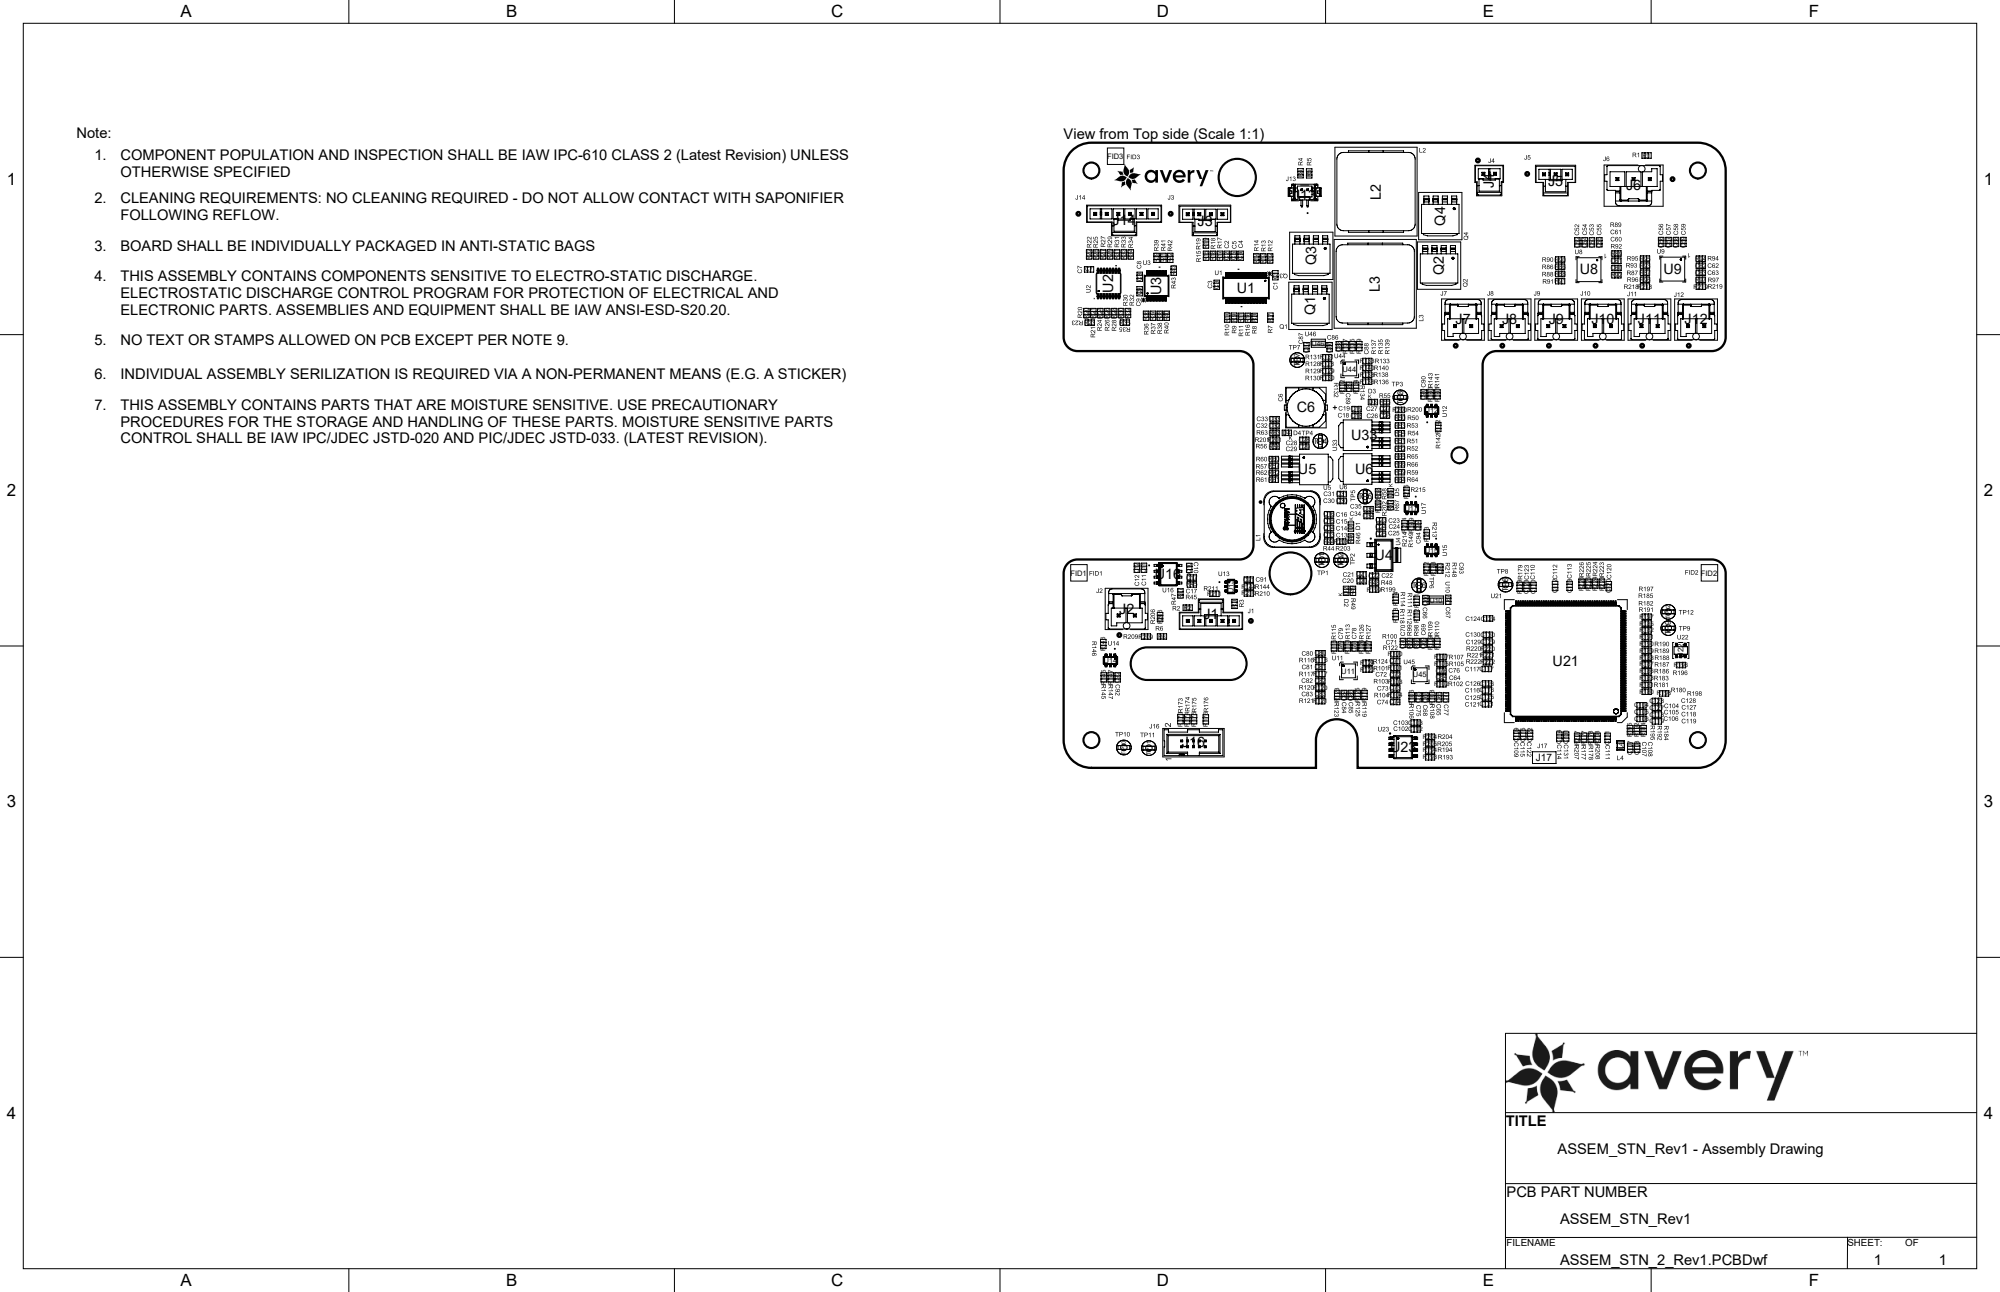
[picture p4: page 1]

Note:
COMPONENT POPULATION AND INSPECTION SHALL BE IAW IPC-610 CLASS 2 (Latest Revision) UNLESS
OTHERWISE SPECIFIED
CLEANING REQUIREMENTS: NO CLEANING REQUIRED - DO NOT ALLOW CONTACT WITH SAPONIFIER
FOLLOWING REFLOW.
3. BOARD SHALL BE INDIVIDUALLY PACKAGED IN ANTI-STATIC BAGS

View from Top side (Scale 1:1)

THIS ASSEMBLY CONTAINS COMPONENTS SENSITIVE TO ELECTRO-STATIC DISCHARGE.
ELECTROSTATIC DISCHARGE CONTROL PROGRAM FOR PROTECTION OF ELECTRICAL AND
ELECTRONIC PARTS. ASSEMBLIES AND EQUIPMENT SHALL BE IAW ANSI-ESD-S20.20.
5. NO TEXT OR STAMPS ALLOWED ON PCB EXCEPT PER NOTE 9.

6. INDIVIDUAL ASSEMBLY SERILIZATION IS REQUIRED VIA A NON-PERMANENT MEANS (E.G. A STICKER)
THIS ASSEMBLY CONTAINS PARTS THAT ARE MOISTURE SENSITIVE. USE PRECAUTIONARY
PROCEDURES FOR THE STORAGE AND HANDLING OF THESE PARTS. MOISTURE SENSITIVE PARTS
CONTROL SHALL BE IAW IPC/JDEC JSTD-020 AND PIC/JDEC JSTD-033. (LATEST REVISION).
