Avery-Digital/Assem-Stn-2-Rev1/Assem_Stn_2_Rev1.pdf

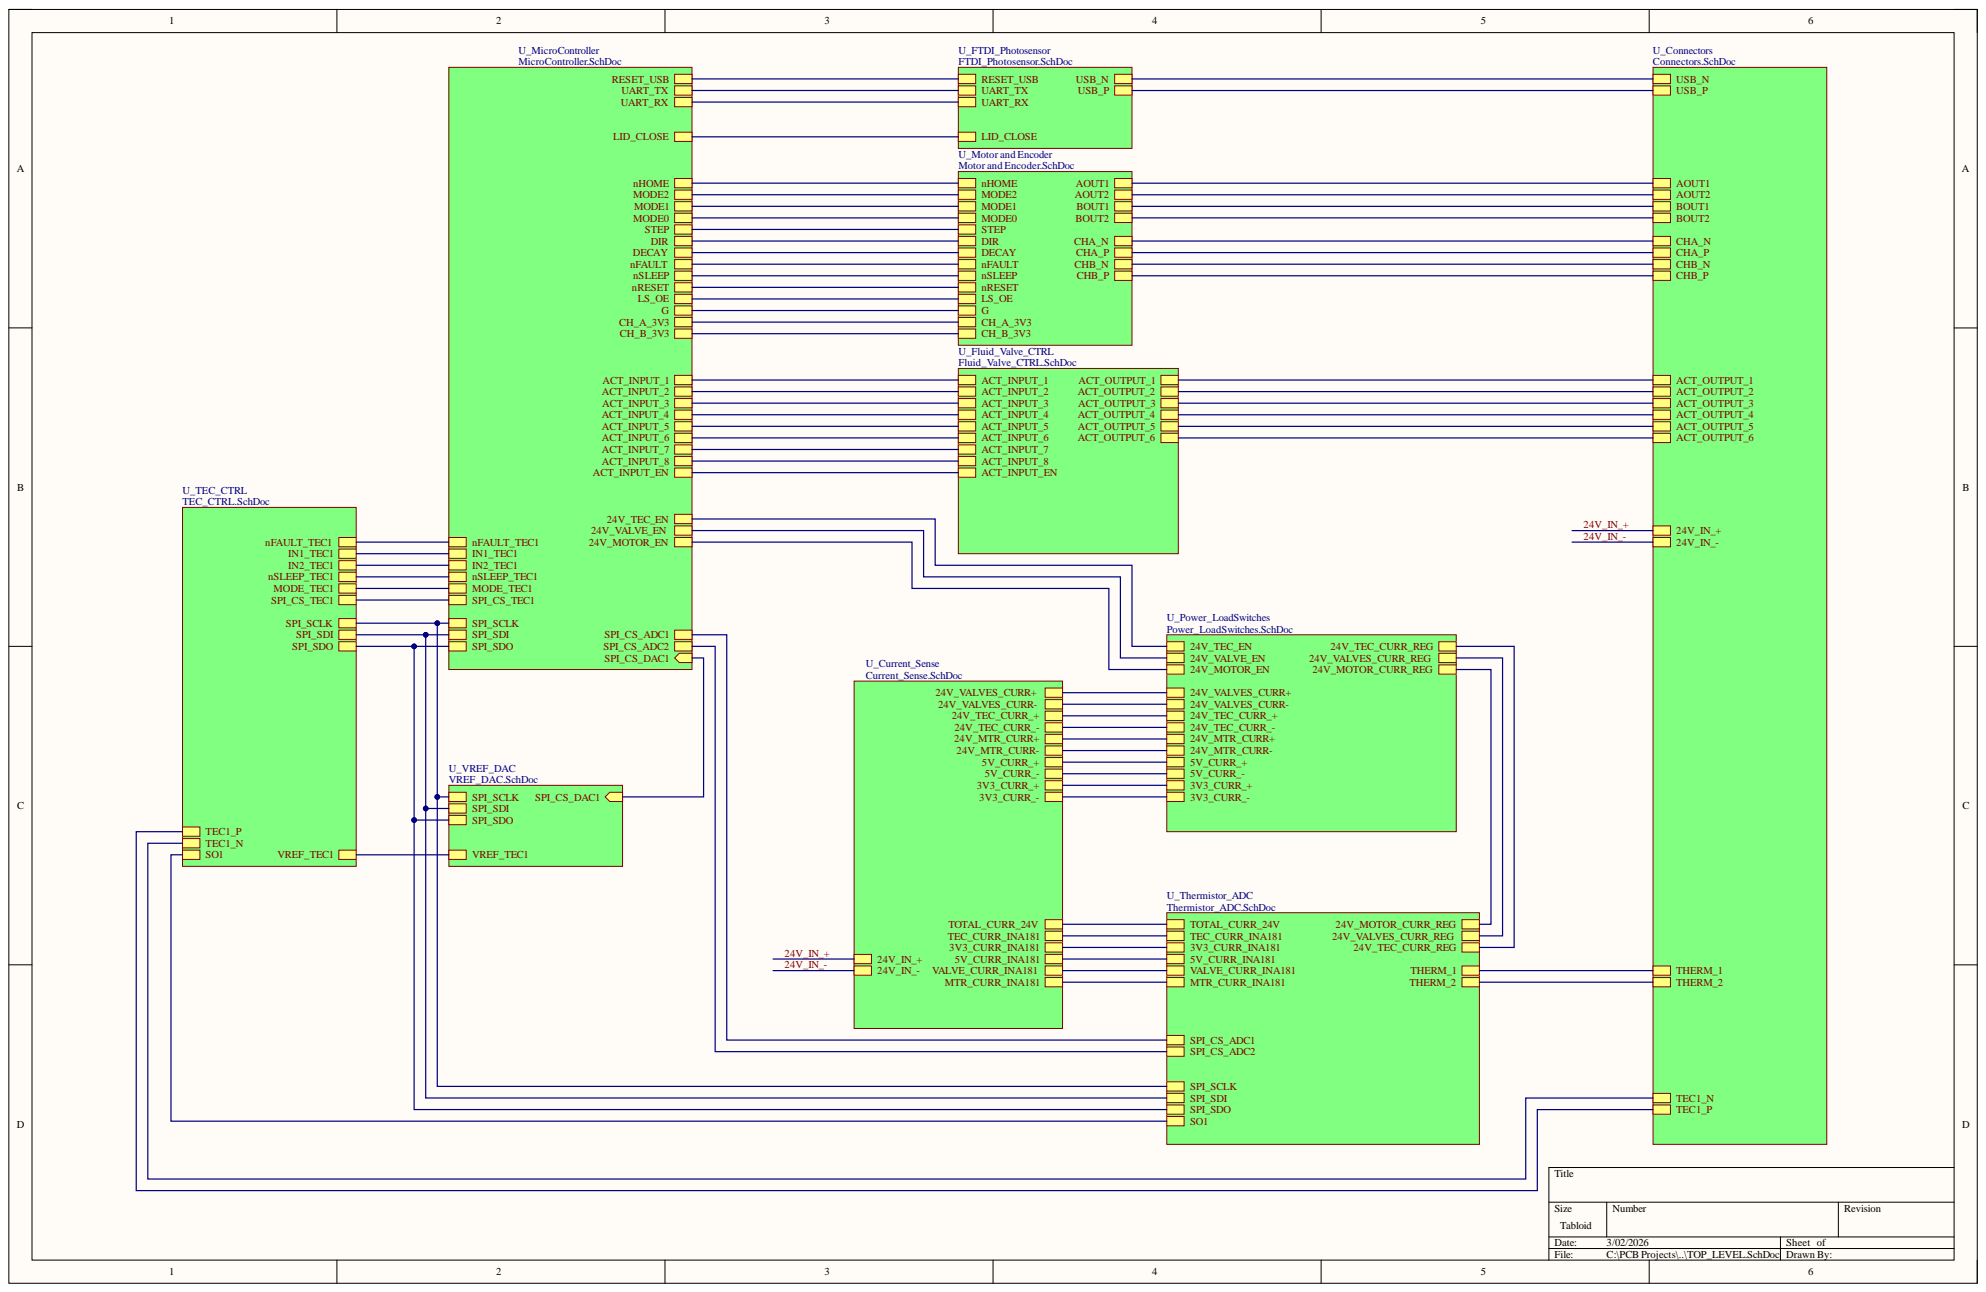
[picture p5: page 1]

SPI_SCLK SPI_CS_DAC1 SPI_SDI | | 3V3_CURR_-

SPI_SDO

SO1 VREF_TEC1 | | VREF_TEC1 | TOTAL_CURR_24V TEC_CURR_INA181 3V3_CURR_INA181 24V_IN_+ 5V_CURR_INA181 24V_IN_-VALVE_CURR_INA181 MTR_CURR_INA181

Size Tabloid | Number | Revision

Date: 3/02/2026 | Sheet of
File: C:\PCB Projects\..\TOP_LEVEL.SchDoc | Drawn By:

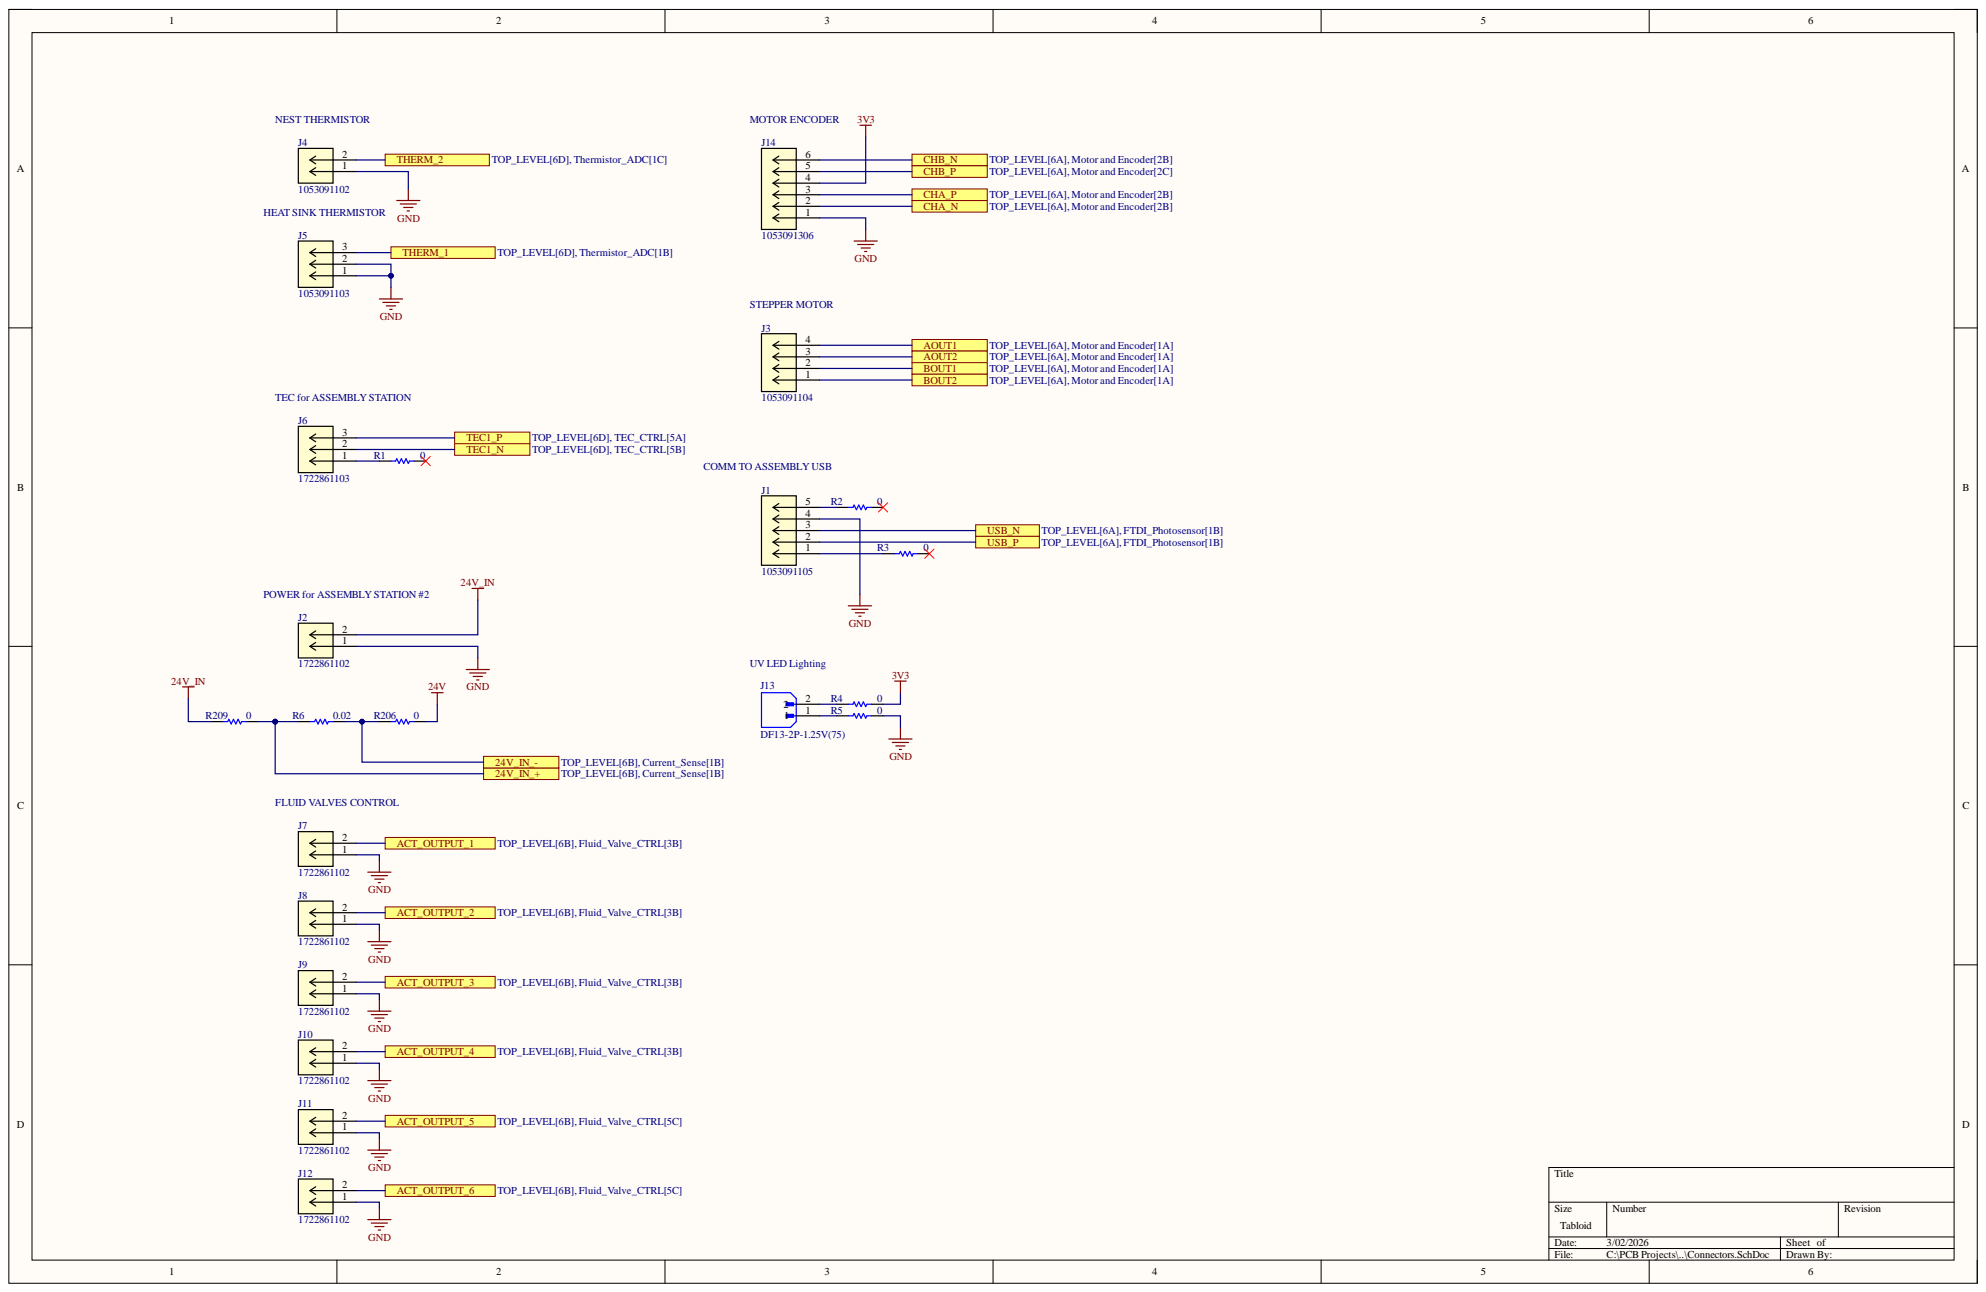
[picture p6: page 2]

TEC for ASSEMBLY STATION

COMM TO ASSEMBLY USB

POWER for ASSEMBLY STATION #2

Size Tabloid | Number | Revision

Date: 3/02/2026 | Sheet of
File: C:\PCB Projects\..\Connectors.SchDoc | Drawn By:

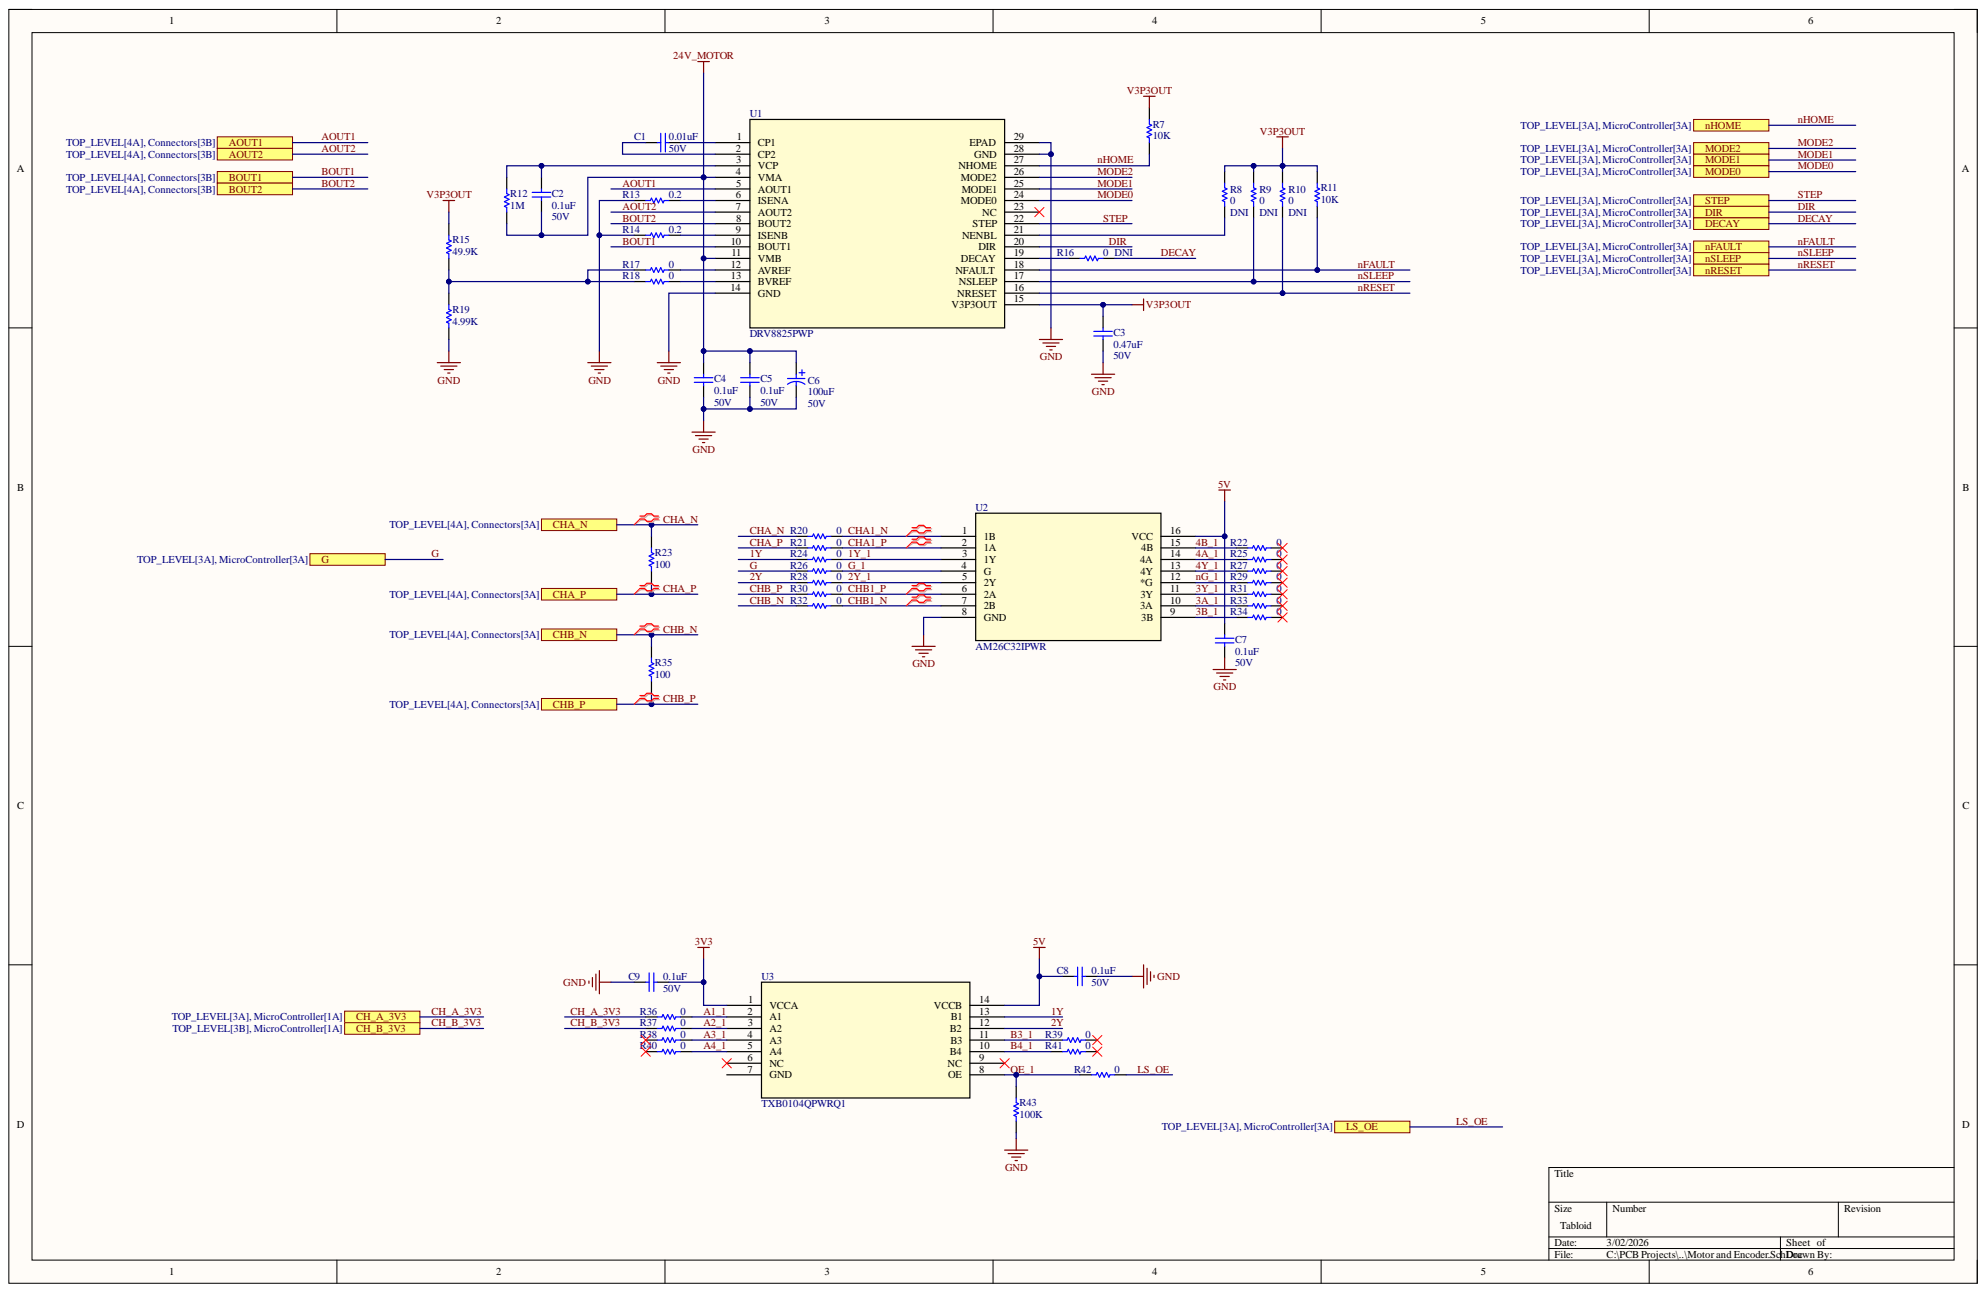
[picture p7: page 3]

VCP 3 | | nHOME

Size Tabloid | Number | Revision

Date: 3/02/2026 | Sheet of
File: C:\PCB Projects\..\Motor and Encoder.SchDraocwn By:

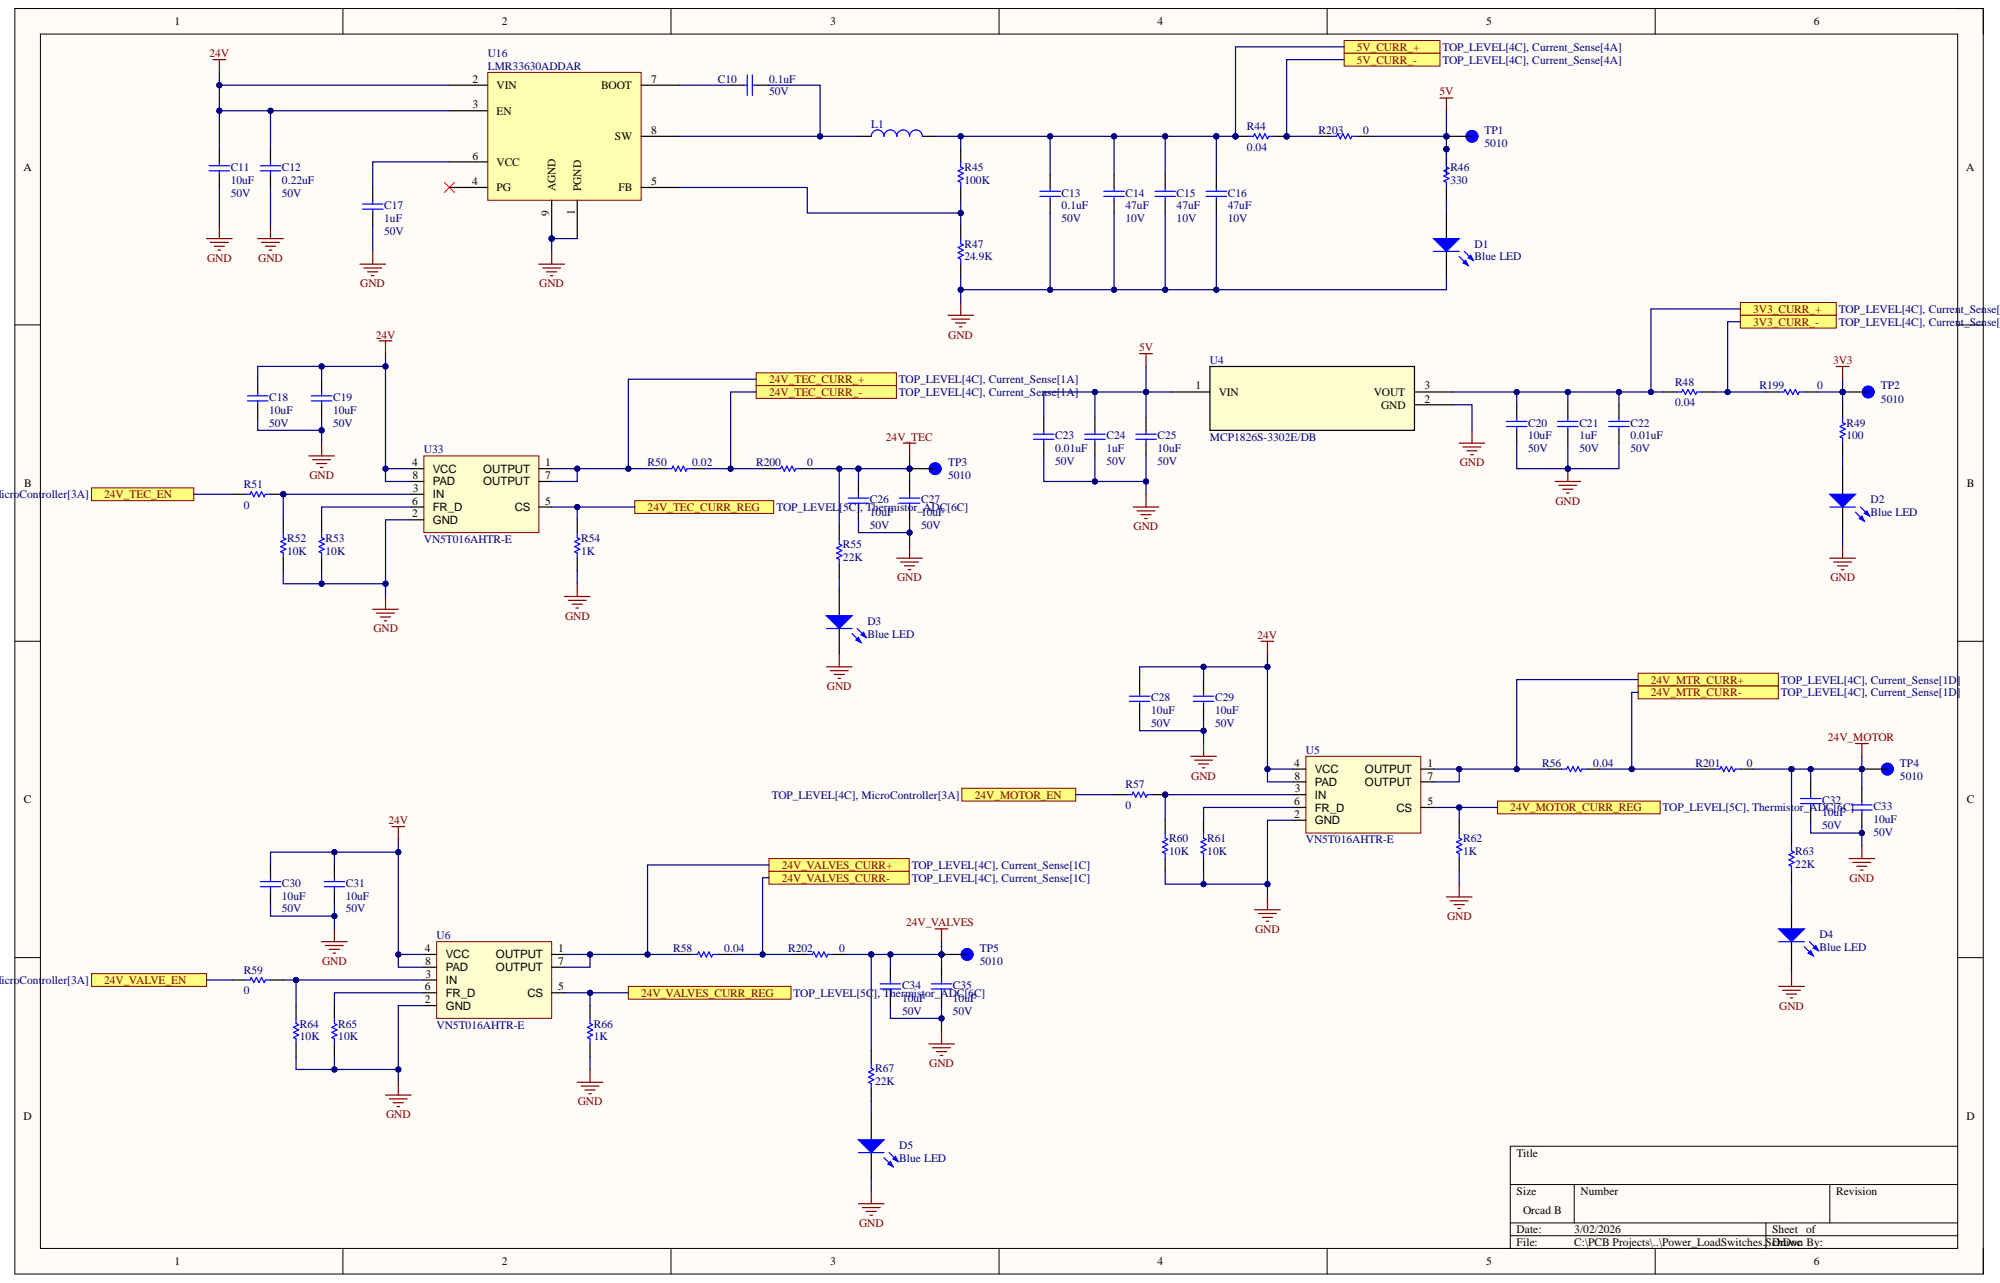
[picture p8: page 4]

GND 2

Size Orcad B | Number | Revision

Date: 3/02/2026 | Sheet of
File: C:\PCB Projects\..\Power_LoadSwitches.SchD Drawocn By:

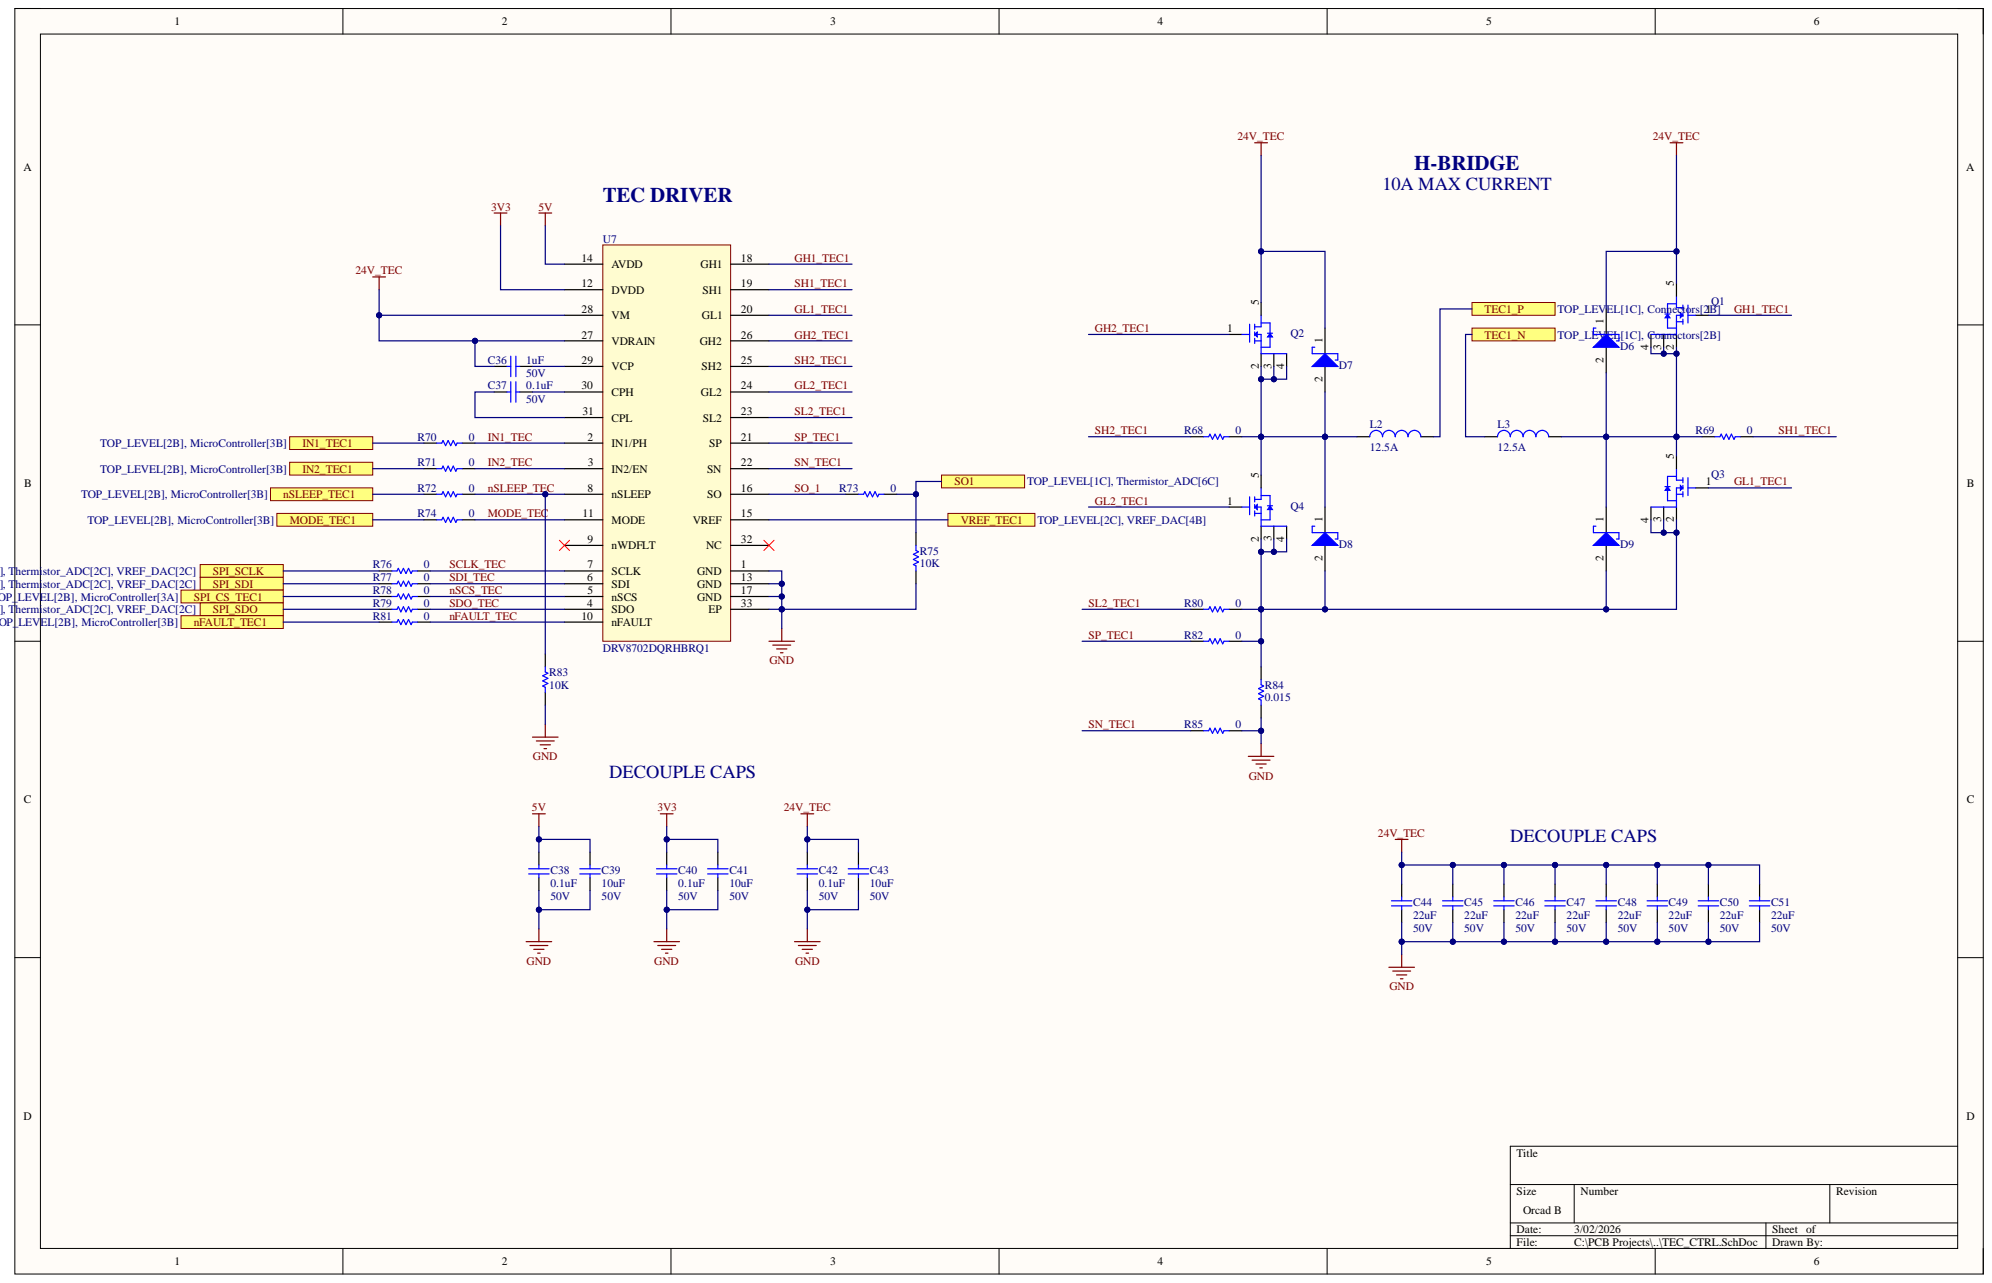
[picture p9: page 5]

Size Orcad B | Number | Revision

Date: 3/02/2026 | Sheet of
Fi l e : C: \PCB Projects\ . . \TEC_CTRL.SchDoc | Drawn By:

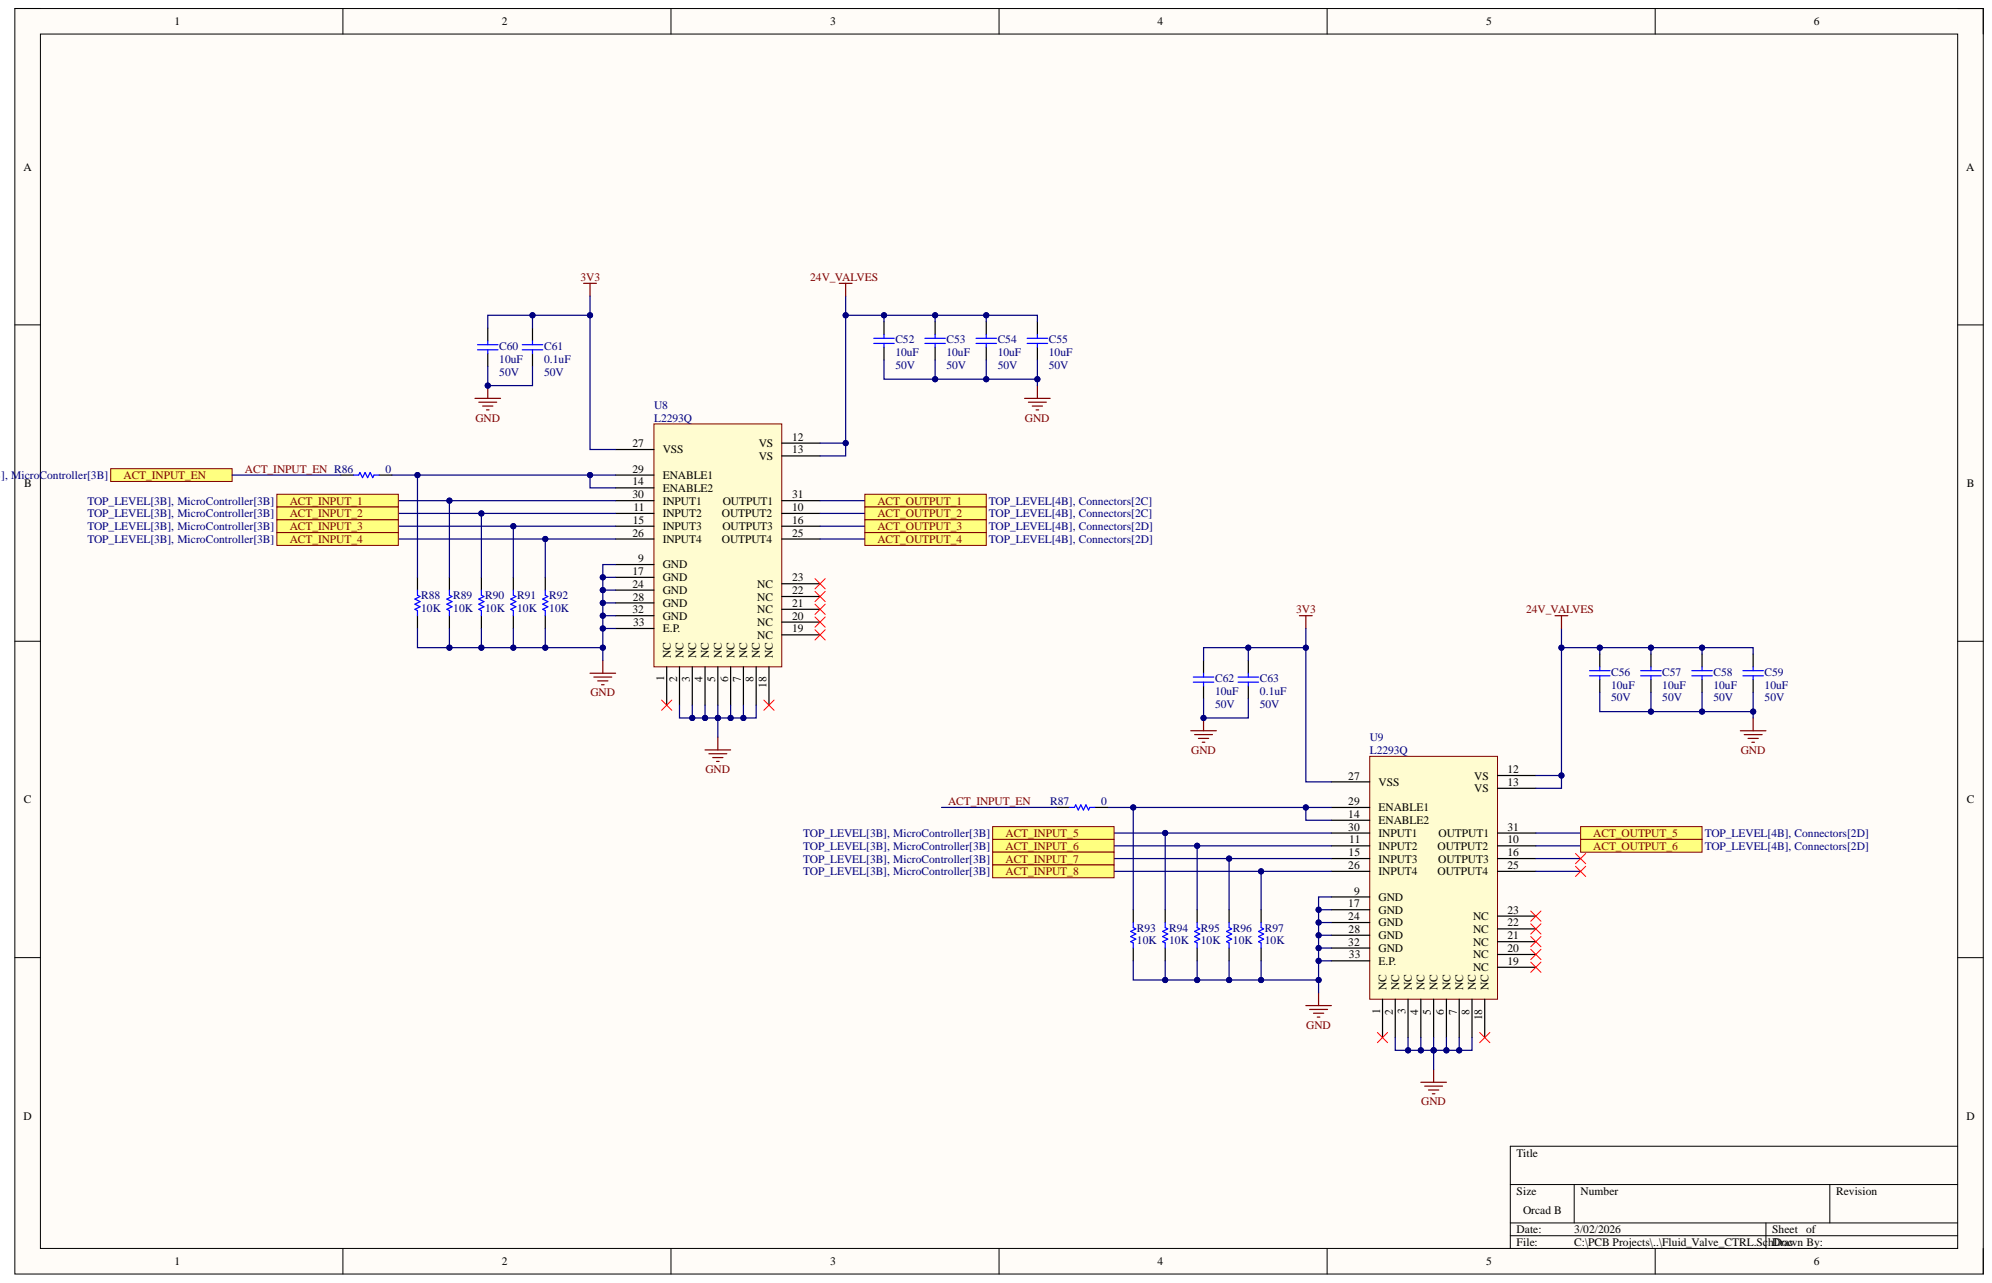
[picture p10: page 6]

Size Orcad B | Number | Revision

Date: 3/02/2026 | Sheet of
File: C:\PCB Projects\..\Fluid_Valve_CTRL.SchDDrawoc n By:

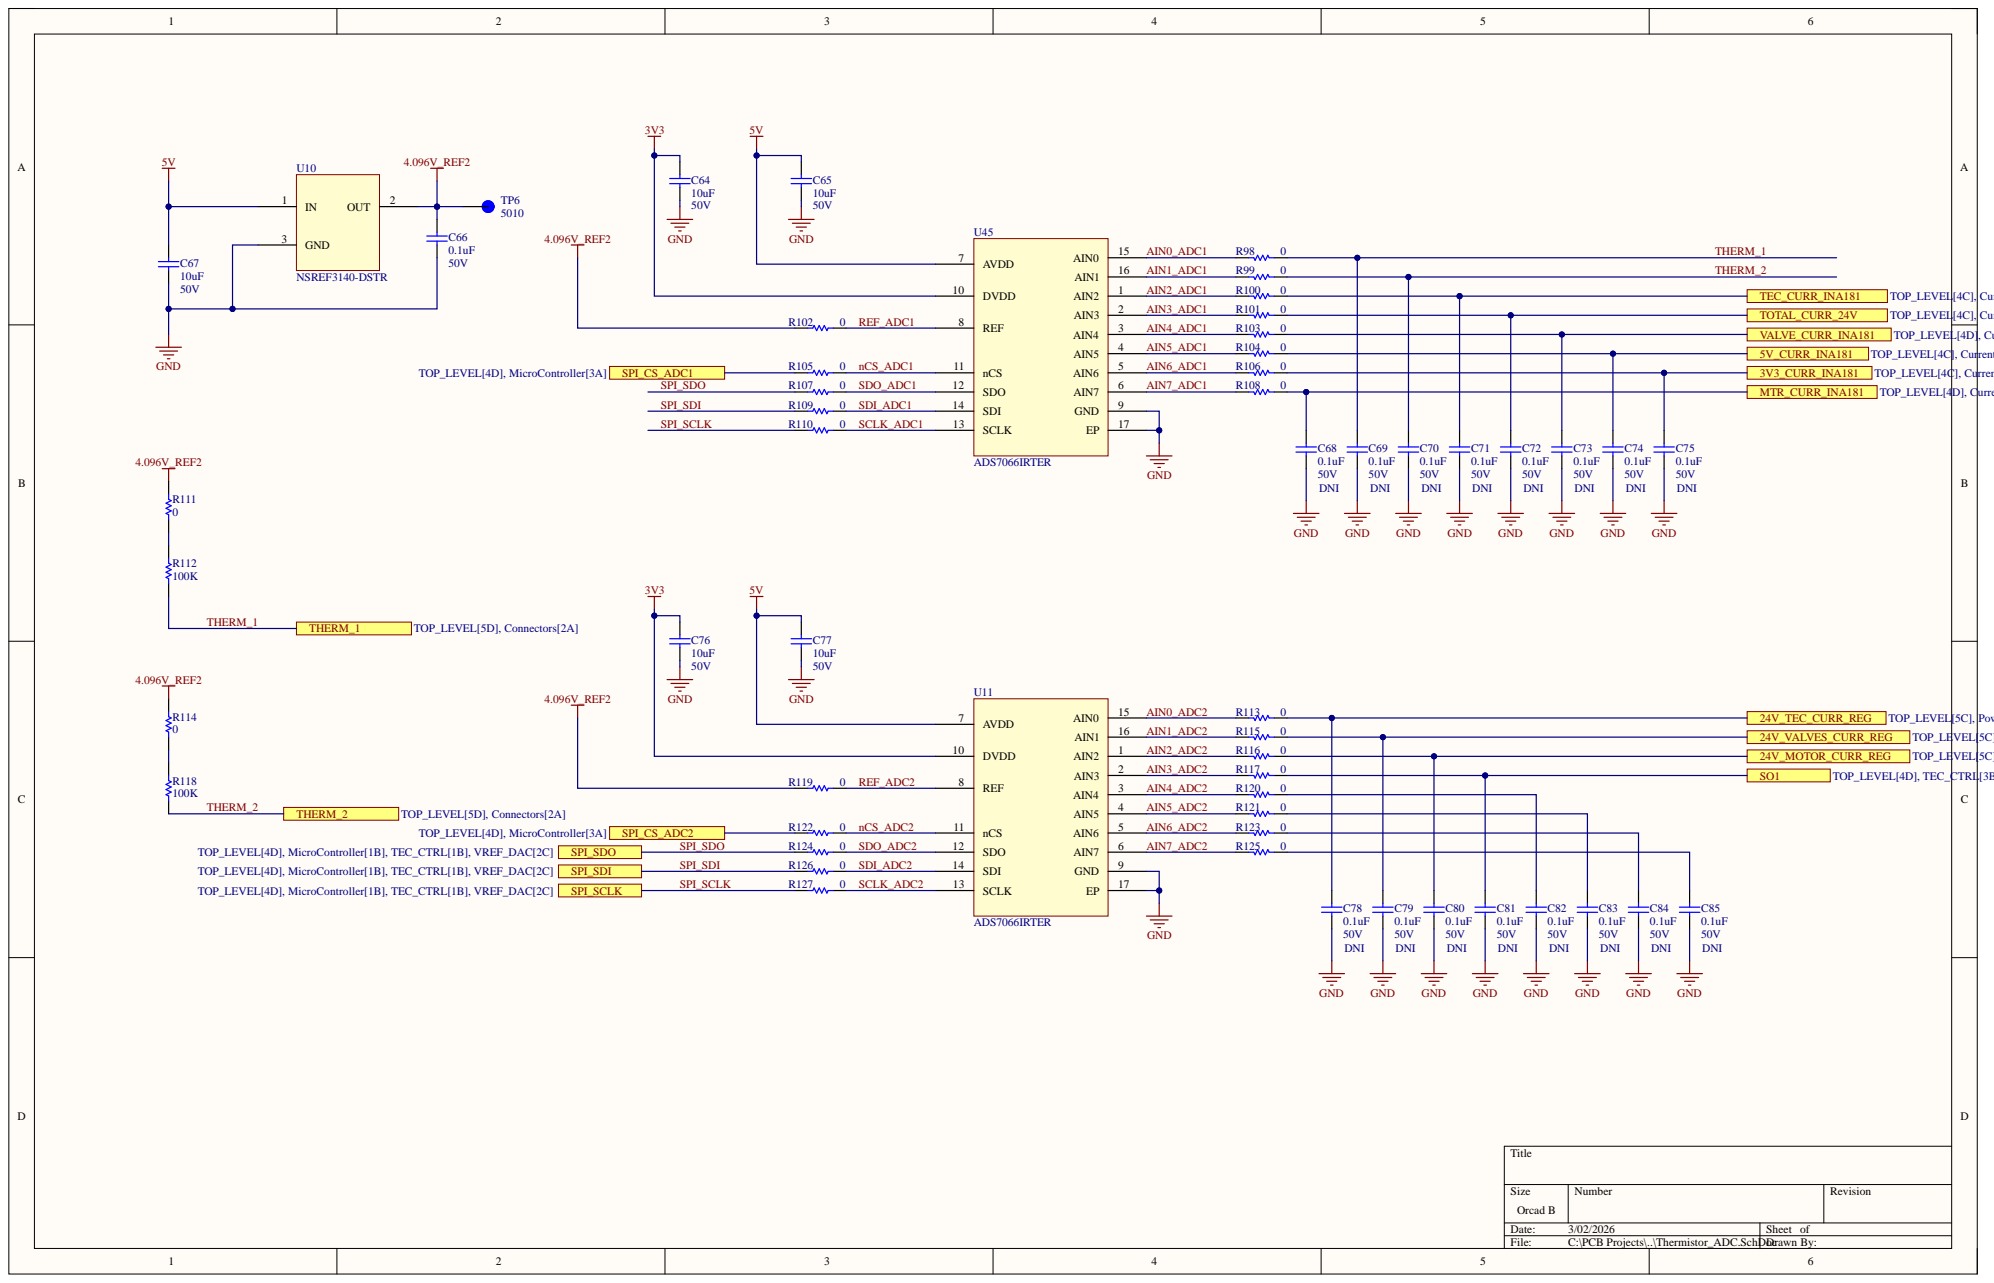
[picture p11: page 7]

Size Orcad B | Number | Revision

Date: 3/02/2026 | Sheet of
File: C:\PCB Projects\..\Thermistor_ADC.SchDocDrawn By:

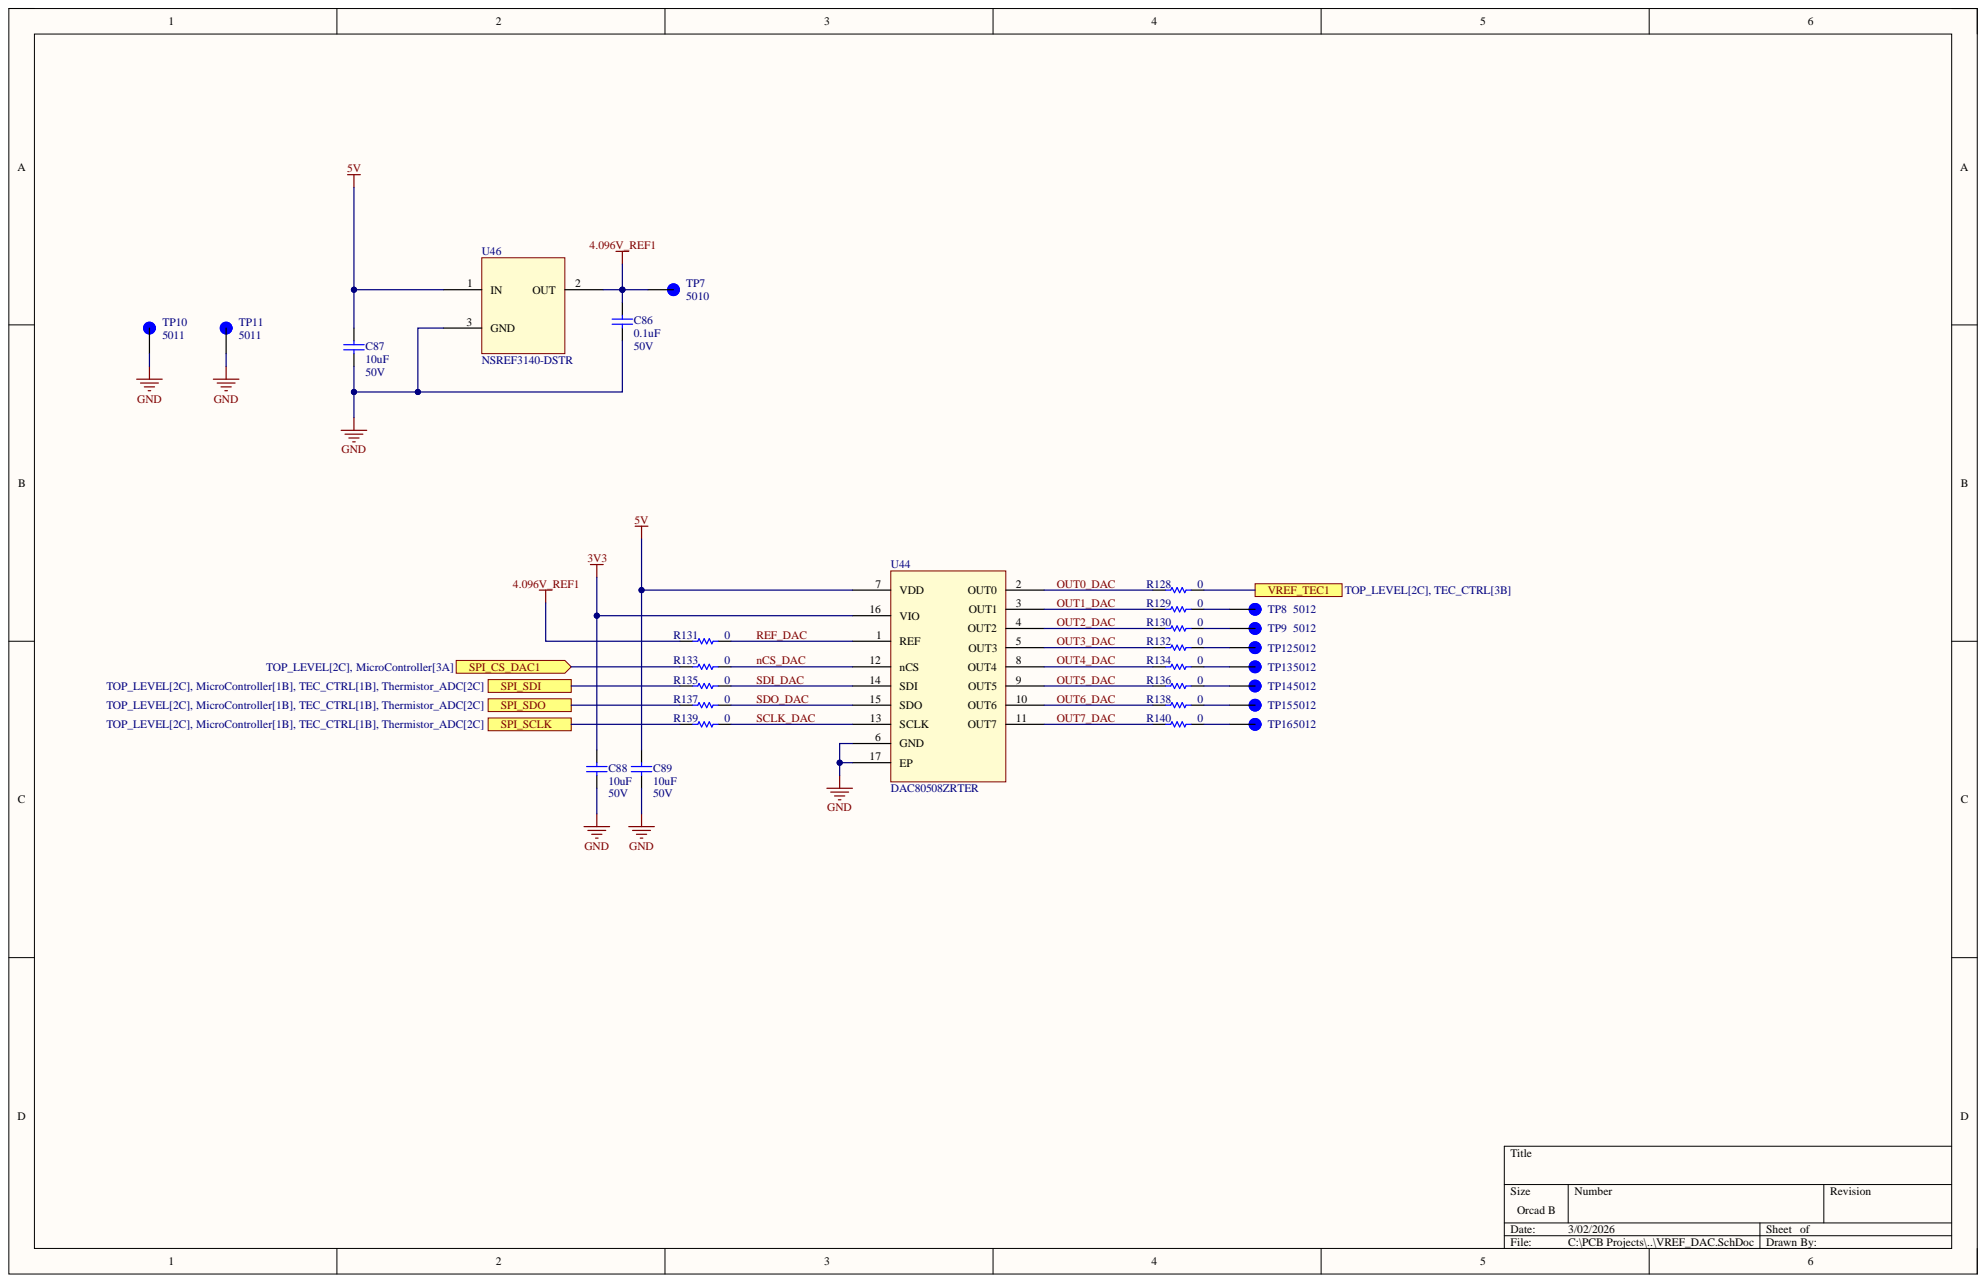
[picture p12: page 8]

VIO 16

REF 1 nCS 12 SDI 14 SDO 15 SCLK 13 GND 6

Size Orcad B | Number | Revision

Date: 3/02/2026 | Sheet of
File: C:\PCB Projects\..\VREF_DAC.SchDoc | Drawn By:

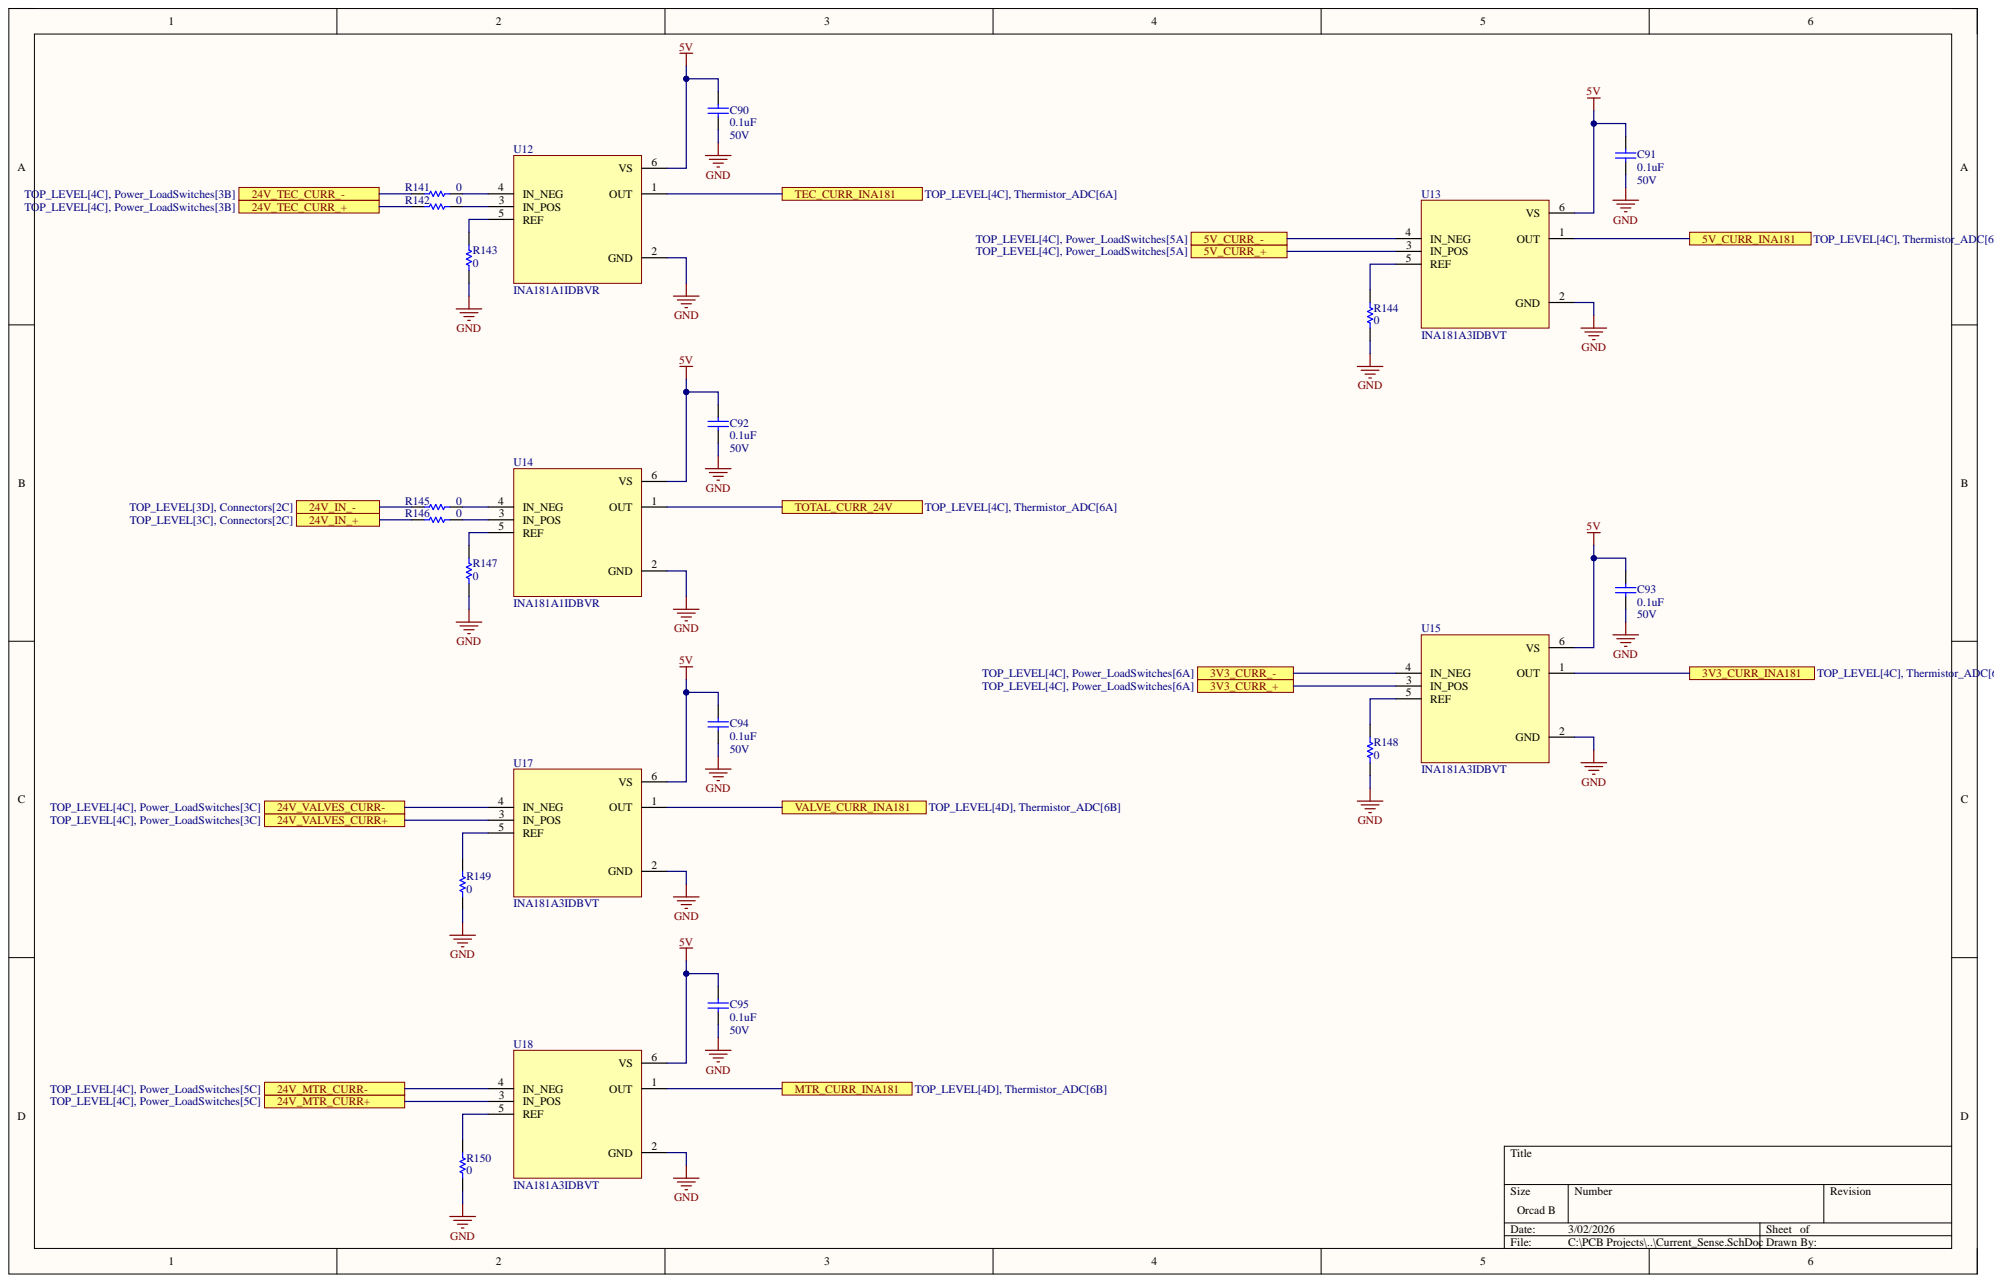
[picture p13: page 9]

REF 5

Size Orcad B | Number | Revision

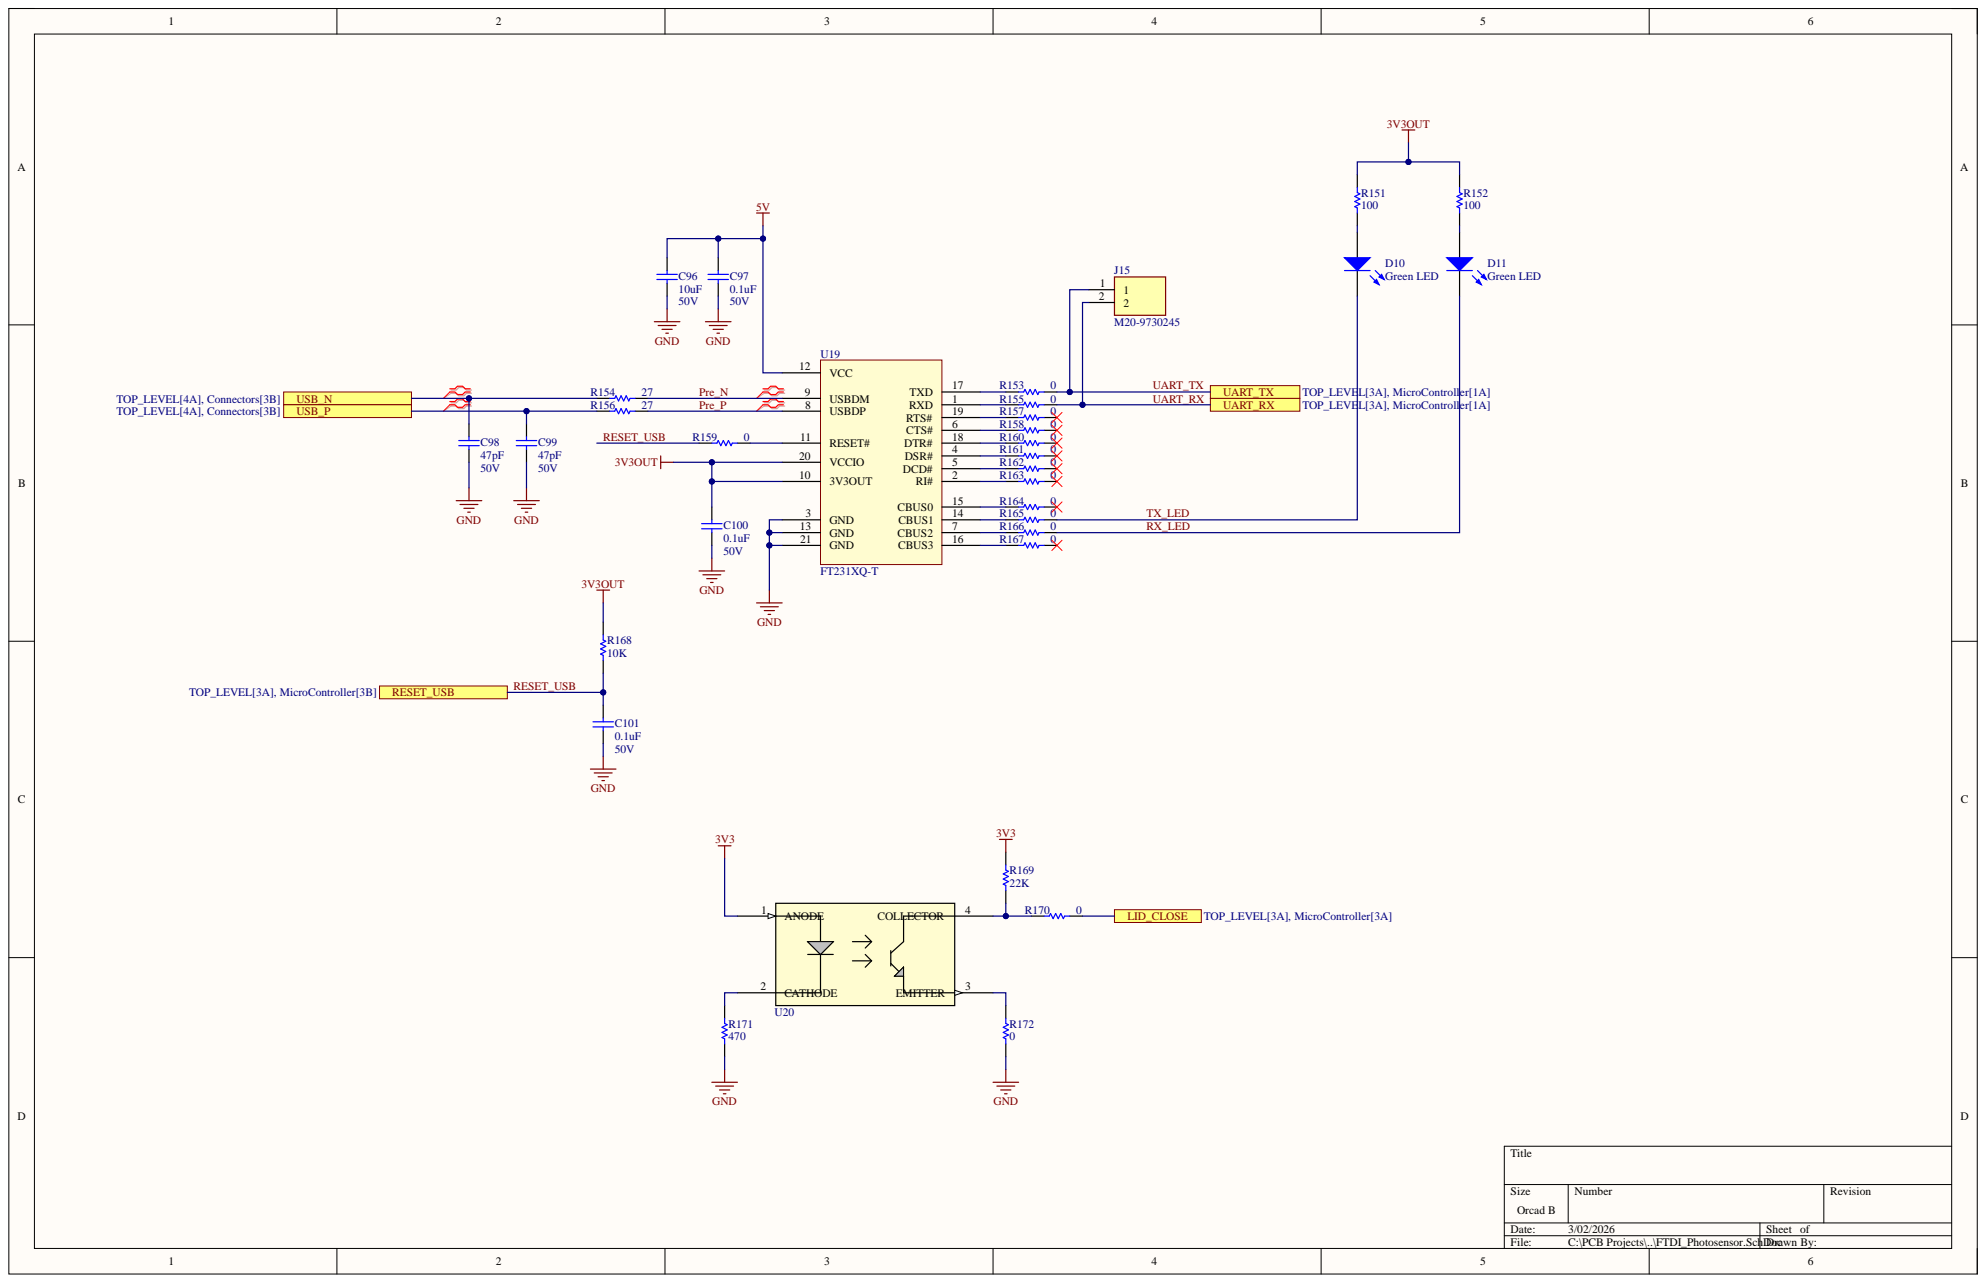
[picture p14: page 10]

Size Orcad B | Number | Revision

Date: 3/02/2026 | Sheet of
File: C:\PCB Projects\..\FTDI_Photosensor.SchDDocrawn By:

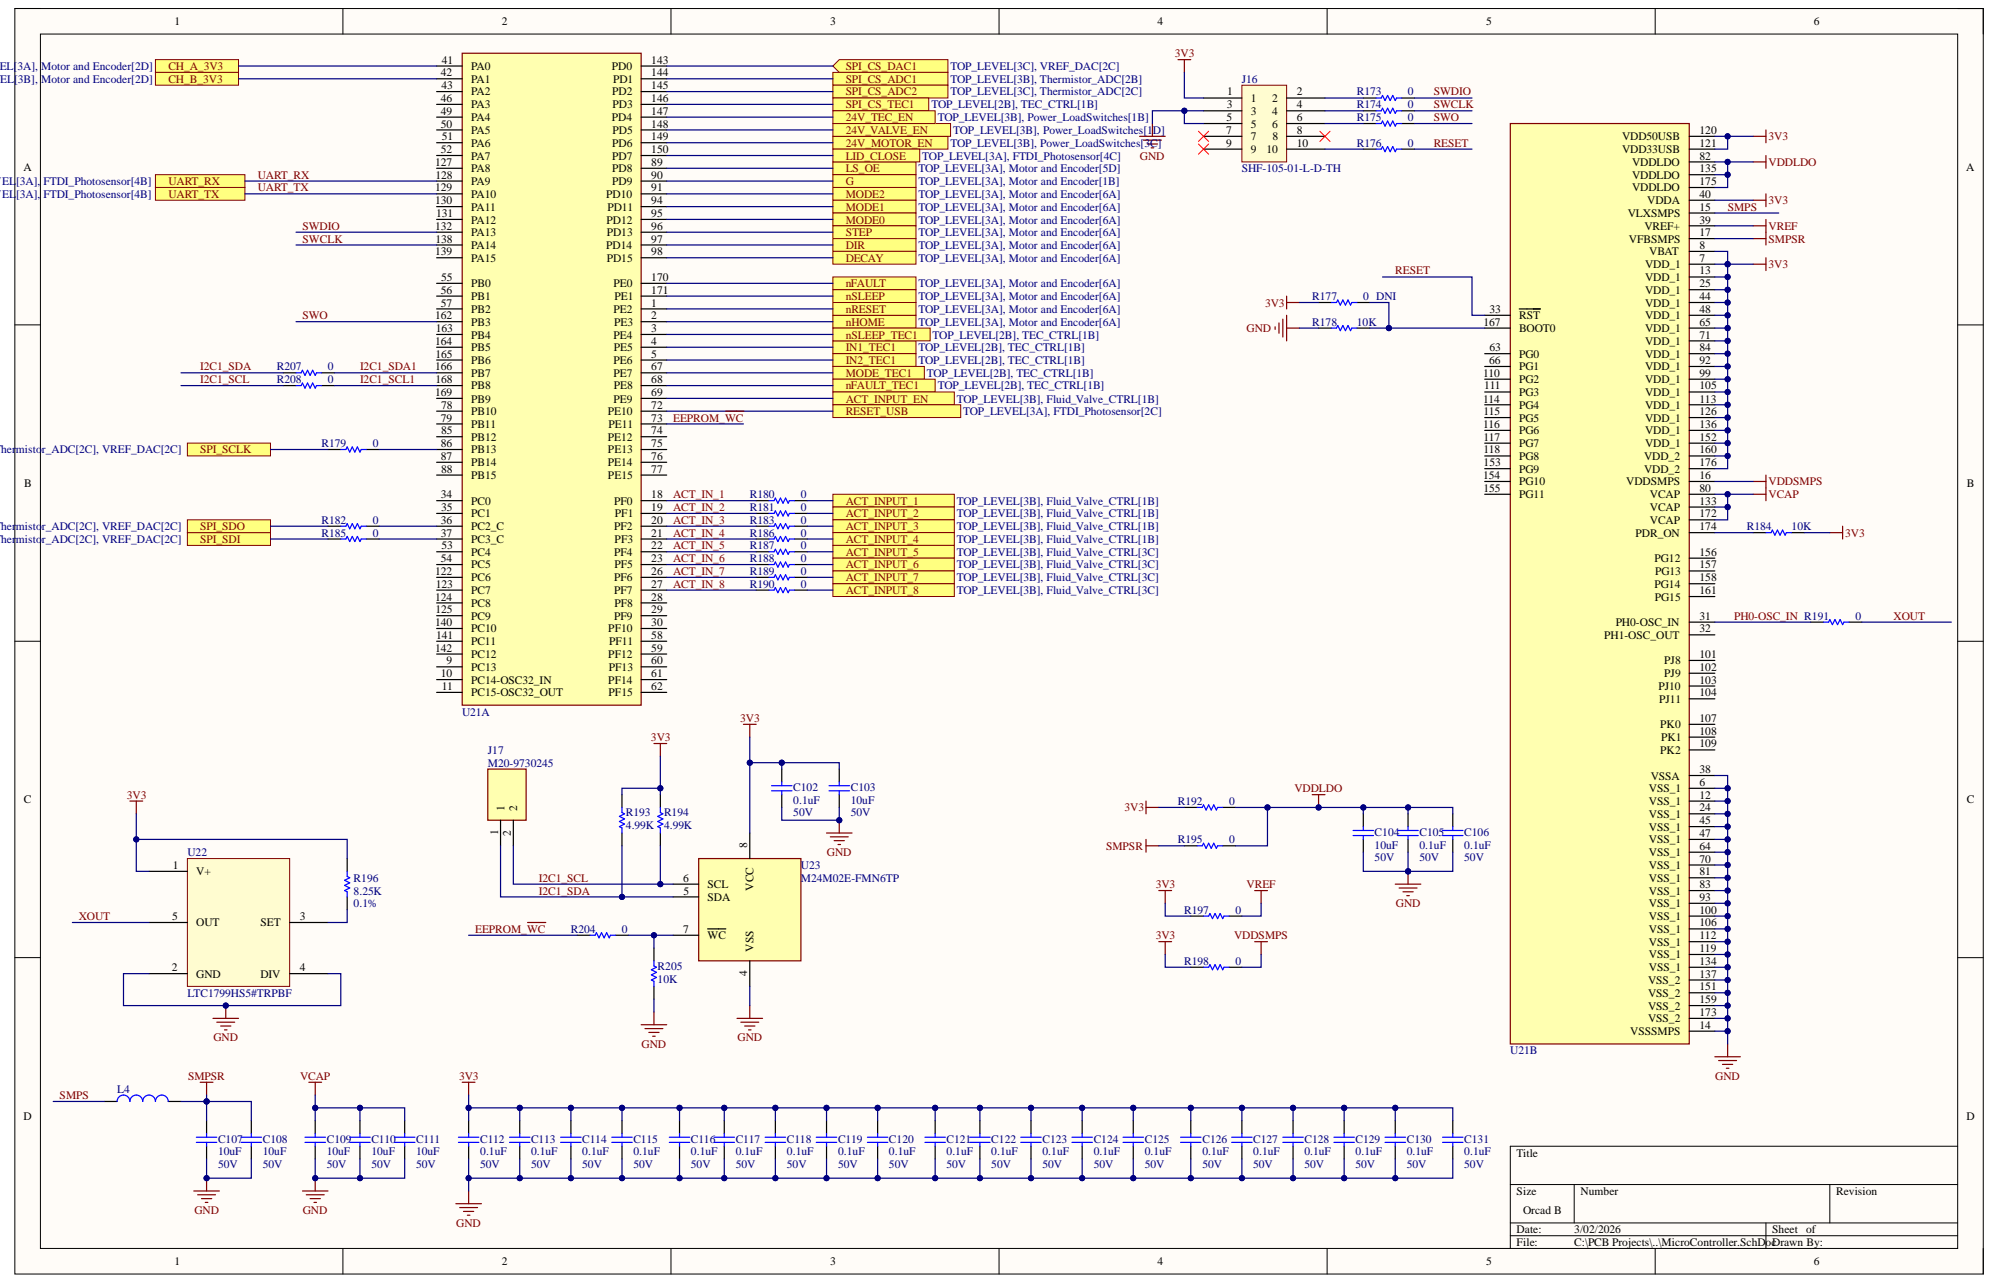
[picture p15: page 11]

Size Orcad B | Number | Revision

Date: 3/02/2026 | Sheet of
File: C:\PCB Projects\..\MicroController.SchDocDrawn By:

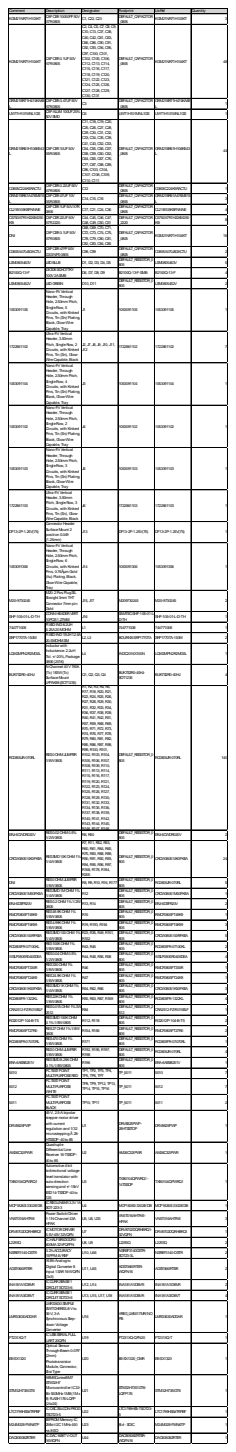
[picture p16: page 12]

KGM21NR71H104KT | CAPCER0.1UF50V X7R0805 | C2, C4, C5, C7, C8, C9, C10, C13, C37, C38, C40, C42, C61, C63, C66, C86, C90, C91, C92, C93, C94, C95, C97, C100, C101, C102, C105, C106, C112, C113, C114, C115, C116, C117, C118, C119, C120, C121, C122, C123, C124, C125, C126, C127, C128, C129, C130, C131 | DEFAULT_CAPACITOR _0805 | KGM21NR71H104KT | | 48

GRM21BR71H474KA88 L | CAPCER0.47UF50V X7R0805 | C3 | DEFAULT_CAPACITOR _0805 | GRM21BR71H474KA88 L | | 1

UWT1H101MNL1GS | CAPALUM100UF20% 50VSMD | C6 | UWT1H101MNL1GS | UWT1H101MNL1GS | | 1

GRM21BR61H106KE43 L | CAPCER10UF50V X5R0805 | C11, C18, C19, C20, C25, C26, C27, C28, C29, C30, C31, C32, C33, C34, C35, C39, C41, C43, C52, C53, C54, C55, C56, C57, C58, C59, C60, C62, C64, C65, C67, C76, C77, C87, C88, C89, C96, C103, C104, C107, C108, C109, C110, C111 | DEFAULT_CAPACITOR _0805 | GRM21BR61H106KE43 L | | 44

C0805C224K5RACTU | CAPCER0.22UF50V X7R0805 | C12 | DEFAULT_CAPACITOR _0805 | C0805C224K5RACTU | | 1

GRM21BR61A476ME15 L | CAPCER47UF10V X5R0805 | C14, C15, C16 | DEFAULT_CAPACITOR _0805 | GRM21BR61A476ME15 L | | 3

CL21B105KBFNNNE | CAPCER1UF50VX7R 0805 | C17, C21, C24, C36 | DEFAULT_CAPACITOR _0805 | CL21B105KBFNNNE | | 4

C5750X7R1H226M250 KB | CAPCER22UF50V X7R2220 | C44, C45, C46, C47, C48, C49, C50, C51 | DEFAULT_CAPACITOR _2220 | C5750X7R1H226M250 KB | | 8

DNI | CAPCER0.1UF50V X7R0805 | C68, C69, C70, C71, C72, C73, C74, C75, C78, C79, C80, C81, C82, C83, C84, C85 | DEFAULT_CAPACITOR _0805 | KGM21NR71H104KT | | 16

C0805X470J5GACTU | CAPCER47PF50V C0G/NP00805 | C98, C99 | DEFAULT_CAPACITOR _0805 | C0805X470J5GACTU | | 2

LSM0805463V | LEDBLUE | D1, D2, D3, D4, D5 | DEFAULT_RESISTOR_0 805 | LSM0805463V | | 5

B2100Q-13-F | DIODESCHOTTKY 100V2ASMB | D6, D7, D8, D9 | B2100Q-13-F-SMB | B2100Q-13-F | | 4

LSM0805452V | LEDGREEN | D10, D11 | DEFAULT_RESISTOR_0 805 | LSM0805452V | | 2

1053091105 | Nano-Fit Vertical Header, Through Hole, 2.50mm Pitch, SingleRow, 5 Circuits, with Kinked Pins, Tin (Sn) Plating, Black, Glow-Wire Capable, Tray | J1 | 1053091105 | 1053091105 | | 1

1722861102 | Ultra-Fit Vertical Header, 3.50mm Pitch, SingleRow, 2 Circuits, with Kinked Pins, Tin (Sn), Glow-Wire Capable, Black | J2, J7, J8, J9, J10, J11, J12 | 1722861102 | 1722861102 | | 7

1053091104 | Nano-Fit Vertical Header, Through Hole, 2.50mm Pitch, SingleRow, 4 Circuits, with Kinked Pins, Tin (Sn) Plating, Black, Glow-Wire Capable, Tray | J3 | 1053091104 | 1053091104 | | 1

1053091102 | Nano-Fit Vertical Header, Through Hole, 2.50mm Pitch, SingleRow, 2 Circuits, with Kinked Pins, Tin (Sn) Plating, Black, Glow-Wire Capable, Tray | J4 | 1053091102 | 1053091102 | | 1

1053091103 | Nano-Fit Vertical Header, Through Hole, 2.50mm Pitch, SingleRow, 3 Circuits, with Kinked Pins, Tin (Sn) Plating, Black, Glow-Wire Capable, Tray | J5 | 1053091103 | 1053091103 | | 1

1722861103 | Ultra-Fit Vertical Header, 3.50mm Pitch, SingleRow, 3 Circuits, with Kinked Pins, Tin (Sn), Glow-Wire Capable, Black | J6 | 1722861103 | 1722861103 | | 1

DF13-2P-1.25V(75) | Connector Header SurfaceMount 2 position 0.049 (1.25mm) | J13 | DF13-2P-1.25V(75) | DF13-2P-1.25V(75) | | 1

1053091306 | Nano-Fit Vertical Header, Through Hole, 2.50mm Pitch, SingleRow, 6 Circuits, with Kinked Pins, 0.76Âµm Gold (Au) Plating, Black, Glow-Wire Capable, Tray | J14 | 1053091306 | 1053091306 | | 1

M20-9730245 | M20: 2PosPlugSIL Straight 3mm THT Connector 7mm pin Gold | J15, J17 | M209730245 | M20-9730245 | | 2

SHF-105-01-L-D-TH | CONN HEADERVERT 10POS1.27MM | J16 | SAMTEC-SHF-105-01-L-D-TH | SHF-105-01-L-D-TH | | 1

744771008 | FIXEDIND8.2UH 6.25A20MOHM | L1 | 744771008 | 744771008 | | 1

SRP1770TA-150M | FIXEDIND15UH12.5A 20.5MOHMSM | L2, L3 | BOURNS-SRP1770TA | SRP1770TA-150M | | 2

LQM2MPN2R2MG0L | Inductor with Inductance: 2.2uH Tol. +/-20%, Package: 0806(2016) | L4 | INDC2016X100N | LQM2MPN2R2MG0L | | 1

BUK7S2R0-40HJ | N-Channel 40V190A (Tc) 183W(Tc) SurfaceMount LFPAK88(SOT1235) | Q1, Q2, Q3, Q4 R1, R2, R3, R4, R5, | BUK7S2R0-40HJ-SOT1235 | BUK7S2R0-40HJ | | 4

RC0805JR-070RL | RES0OHMJUMPER 1/8W0805 | R17, R18, R20, R21, R22, R24, R25, R26, R27, R28, R29, R30, R31, R32, R33, R34, R36, R37, R38, R39, R40, R41, R42, R51, R57, R59, R68, R69, R70, R71, R72, R73, R74, R76, R77, R78, R79, R80, R81, R82, R85, R86, R87, R98, R99, R100, R101, R102, R103, R104, R105, R106, R107, R108, R109, R110, R111, R113, R114, R115, R116, R117, R119, R120, R121, R122, R123, R124, R125, R126, R127, R128, R129, R130, R131, R132, R133, R134, R135, R136, R137, R138, R139, R140, R141, R142, R143, R144, R145, R146, R147, R148, | DEFAULT_RESISTOR_0 805 | RC0805JR-070RL | 140

ERJ-6CWDR020V | RES0.02OHM0.5% 1/2W0805 | R6, R50 | DEFAULT_RESISTOR_0 805 | ERJ-6CWDR020V | | 2

CRCW080510K0FKEA | RESSMD10KOHM1% 1/4W0805 | R7, R11, R52, R53, R60, R61, R64, R65, R75, R83, R88, R89, R90, R91, R92, R93, R94, R95, R96, R97, R168, R178, R184, R205 | DEFAULT_RESISTOR_0 805 | CRCW080510K0FKEA | | 24

DNI | RES0OHMJUMPER 1/8W0805 | R8, R9, R10, R16, R177 | DEFAULT_RESISTOR_0 805 | RC0805JR-070RL | | 5

CRCW08051M00FKEA | RESSMD1MOHM1% 1/4W0805 | R12 | DEFAULT_RESISTOR_0 805 | CRCW08051M00FKEA | | 1

ERJ-6DSFR20V | RES0.2OHM1%1/2W 0805 | R13, R14 | DEFAULT_RESISTOR_0 805 | ERJ-6DSFR20V | | 2

RMCF0805FT49K9 | RES49.9KOHM1% 1/8W0805 | R15 | DEFAULT_RESISTOR_0 805 | RMCF0805FT49K9 | | 1

RMCF0805FT4K99 | RES4.99KOHM1% 1/8W0805 | R19, R193, R194 | DEFAULT_RESISTOR_0 805 | RMCF0805FT4K99 | | 3

CRCW0805100RFKEA | RESSMD100OHM1% 1/4W0805 | R23, R35, R49, R151, R152 | DEFAULT_RESISTOR_0 805 | CRCW0805100RFKEA | | 5

RC0805FR-07100KL | RES100KOHM1% 1/8W0805 | R43, R45 | DEFAULT_RESISTOR_0 805 | RC0805FR-07100KL | | 2

WSLP0805R0400DEA | RES0.04OHM0.5% 1/2W0805 | R44, R48, R56, R58 | DEFAULT_RESISTOR_0 805 | WSLP0805R0400DEA | | 4

RMCF0805FT330R | RES330OHM1% 1/8W0805 | R46 | DEFAULT_RESISTOR_0 805 | RMCF0805FT330R | | 1

RMCF0805FT24K9 | RES24.9KOHM1% 1/8W0805 | R47 | DEFAULT_RESISTOR_0 805 | RMCF0805FT24K9 | | 1

CRCW08051K00FKEA | RESSMD1KOHM1% 1/4W0805 | R54, R62, R66 | DEFAULT_RESISTOR_0 805 | CRCW08051K00FKEA | | 3

RC0805FR-1322KL | RES22KOHM1% 1/8W0805 | R55, R63, R67, R169 | DEFAULT_RESISTOR_0 805 | RC0805FR-1322KL | | 4

CRA2512-FZ-R015ELF | RES0.015OHM1%3W 2512 | R84 | DEFAULT_RESISTOR_2 512 | CRA2512-FZ-R015ELF | | 1

RG2012P-104-B-T5 | RESSMD100KOHM 0.1%1/8W0805 | R112, R118 | DEFAULT_RESISTOR_0 805 | RG2012P-104-B-T5 | | 2

RMCF0805FT27R0 | RES27OHM1%1/8W 0805 | R154, R156 | DEFAULT_RESISTOR_0 805 | RMCF0805FT27R0 | | 2

RC0805FR-07470RL | RES470OHM1% 1/8W0805 | R171 | DEFAULT_RESISTOR_0 805 | RC0805FR-07470RL | | 1

RES0OHMJUMPER 1/8W0805 | R192, R195, R197, R198 | DEFAULT_RESISTOR_0 805 | RC0805JR-070RL | | 4

ERA-6AEB8251V | RESSMD8.25KOHM 0.1%1/8W0805 | R196 | DEFAULT_RESISTOR_0 805 | ERA-6AEB8251V | | 1

5010 | PCTESTPOINT MULTIPURPOSERED | TP1, TP2, TP3, TP4, TP5, TP6, TP7 | TP_5011 | 5010 | | 7

5012 | PCTESTPOINT MULTIPURPOSE WHITE | TP8, TP9, TP12, TP13, TP14, TP15, TP16 | TP_5011 | 5012 | | 7

5011 | PCTESTPOINT MULTIPURPOSE BLACK | TP10, TP11 | TP_5011 | 5011 | | 2

DRV8825PWP | 45-V, 2.5-Abipolar stepper motor driver with current regulation and 1/32 microsteppingÂ 28-HTSSOP-40to 85 | U1 | DRV8825PWP-28HTSSTOP | DRV8825PWP | | 1

AM26C32IPWR | Quadruple Differential Line Receiver 16-TSSOP-40to 85 | U2 | AM26C32IPWR | AM26C32IPWR | | 1

TXB0104QPWRQ1 | Automotive4-bit bidirectional voltage-level translator with auto direction sensingand +/-15kV ESD14-TSSOP-40to 125 | U3 | TXB0104QPWRQ1-14TSSOP | TXB0104QPWRQ1 | | 1

MCP1826S-3302E/DB | ICREGLINEAR3.3V1A SOT-223-3 | U4 | MCP1826S-3302E/DB | MCP1826S-3302E/DB | | 1

VN5T016AHTR-E | Power Switch/Driver 1:1N-Channel 43A HPAK | U5, U6, U33 | VN5T016AHTR-E-HPAK | VN5T016AHTR-E | | 3

DRV8702DQRHBRQ1 | ICMOTORDRIVER 5.5V-45V32VQFN | U7 | DRV8702DQRHBRQ1-32VQFN | DRV8702DQRHBRQ1 | | 1

L2293Q | ICHALFBRIDGDRV 600MA32VFQFPN | U8, U9 | L2293Q | L2293Q | | 2

NSREF3140-DSTR | 0.2%ACCURACY 15PPM4VREF | U10, U46 | NSREF3140DSTR-SOT23-3L | NSREF3140-DSTR | | 2

ADS7066IRTER | 16Bit Analogto Digital Converter 8 Input 1SAR16-WQFN (3x3) | U11, U45 | ADS7066IRTER-WQFN16 | ADS7066IRTER | | 2

INA181A1IDBVR | ICCURRSENSE1 CIRCUITSOT23-6 | U12, U14 | INA181A1IDBVR | INA181A1IDBVR | | 2

INA181A3IDBVT | ICCURRSENSE1 CIRCUITSOT23-6 | U13, U15, U17, U18 | INA181A1IDBVR | INA181A3IDBVT | | 4

LMR33630ADDAR | LMR33630SIMPLE SWITCHER®3.8-Vto 36-V, 3-A SynchronousStep-down Voltage Converter | U16 | VREG_LM5017MR/NO PB | LMR33630ADDAR | | 1

FT231XQ-T | ICUSBSERIALFULL UART20QFN | U19 | FT231XQ-QFN20 | FT231XQ-T | | 1

EE-SX1320 | Optical Sensor Through-Beam 0.079" (2mm) Phototransistor Module, Connector, Slot Type | U20 | EE-SX1320_OMR | EE-SX1320 | | 1

STM32H735IGT6 | ARM®Cortex®-M7 STM32H7 Microcontroller IC32-Bit 550MHz1MB(1Mx 8) FLASH176-LQFP (24x24) | U21 | STM32H7351GT6-LQFP176 | STM32H735IGT6 | | 1

LTC1799HS5#TRPBF | ICOSCSILICON PROG TSOT23-5 | U22 | LTC1799HS5-TSOT23-5 | LTC1799HS5#TRPBF | | 1

M24M02E-FMN6TP | EEPROMMemory IC 2Mbit I2C1MHz450 ns 8-SO | U23 | 8ld - SOIC | M24M02E-FMN6TP | | 1

DAC80508ZRTER | ICDAC16BITV-OUT 16WQFN | U44 | DAC80508ZRTER-WQFN16 | DAC80508ZRTER | | 1
