Avery-Digital/Assem-Stn-2-Rev1/(list of files, drawings)

Other design files:
Assem_Stn_2_Rev1.PrjPcb
Connectors.SchDoc
Current_Sense.SchDoc
Fluid_Valve_CTRL.SchDoc
FTDI_Photosensor.SchDoc
MicroController.SchDoc
Motor and Encoder.SchDoc
Power_LoadSwitches.SchDoc
TEC_CTRL.SchDoc
Thermistor_ADC.SchDoc
TOP_LEVEL.SchDoc
VREF_DAC.SchDoc
