Avery-Digital/Assem-Stn-2-Rev1/(commit log)

2026-04-16 Initial commit - Assem_Stn_2_Rev1 Altium project
    Assembly Station #2 control PCB including schematics, PCB layout,
    Gerber/drill outputs, BOM, pick-and-place, and fab house package.
    [ASSEM_STN_2_Rev1_Copper_Signal_1.gbr, ASSEM_STN_2_Rev1_Copper_Signal_2.gbr, ASSEM_STN_2_Rev1_Copper_Signal_3.gbr, ASSEM_STN_2_Rev1_Copper_Signal_4.gbr, ASSEM_STN_2_Rev1_Copper_Signal_5.gbr, ASSEM_STN_2_Rev1_Copper_Signal_6.gbr, ASSEM_STN_2_Rev1_Copper_Signal_Bot.gbr, ASSEM_STN_2_Rev1_Copper_Signal_Top.gbr]
2026-04-17 Update MicroController schematic, add Datasheets to gitignore
    [MicroController.SchDoc]
